marcoallegretti/Teresina-Rack/docs/review/analog-review/aux-and-analog-final-review.md

# Connected analog pages: final independent review

Pages 8 (CV inputs), 9 (auxiliary ADC/CV outputs) and 10 (gates) pass scoped native preservation and visual review. Other sheets remain drafts. No CAD files were edited by this reviewer.

All 211 components and 856 native pin nets, functions and types independently match the core candidate after removing only the root slash. All analog values, order codes, footprints, datasheets and electrical descriptions remain unchanged. The sole non-sheet documentary delta is U3 Description, duplicated in its description tag and field. The separate core review accepted its library alias and description normalization. All 84 raw analog symbol instances preserve units, library IDs, symbol/pin UUIDs and electrical property strings.

The final filtered CV input nodes are exactly:

- CVO_FILT_1: R152.2, C138.1 and U15.3.
- CVO_FILT_2: R153.2, C139.1 and U15.5.

Explicit T junctions now connect both capacitor branches to the opamp plus-input wires. The earlier disconnected RC export was rejected. Both 62 kΩ/120 kΩ feedback loops are visible and sense their outputs before the 100 Ω series resistors. The shared U15 supply is clearly referenced to the gates sheet.

Each auxiliary ADC channel visibly includes 1 kΩ series resistance and 1 nF to ground. Actual MCU symbol functions remain PA1_N2, PA0_N3, PC3_C_M5 and PC2_C_M4 for channels 9–12, respectively. This preserves the reviewed core connections; it is not a separate firmware qualification claim.

ADC 10 and 12 groups moved left by 6.35 mm. The final crop confirms both output label boxes clear the inner drawing frame. No material overlap between text, pins or component bodies, or hidden feedback path, was found on the three reviewed pages. Prior scoped visual acceptance for CV inputs and gates is retained.

The reviewed PDF is newer than all three sheets, and its saved hash still matches the current final export. `aux-and-analog-final-review.json` records PDF, sheet and XML hashes, exact RC/feedback memberships, ADC mappings and evidence PNG filenames. Fresh ERC retains three pin-to-pin errors and one library mismatch. Exact device behavior, rail/headroom limits, fault protection, noise/THD, effective capacitance, physical bypass placement and PCB parity remain open. Readability does not certify those checks; this is not whole-schematic or production acceptance.
