marcoallegretti/Teresina-Rack/docs/review/analog-review/connected-cv-gates-review.md

# Connected CV/gate sheet review

Pages8(CVinputs) and10(gates) pass scoped native and visual review. Fresh PDF is newer than both revised sheets; hashes and evidence are in `connected-cv-gates-review.json`. All211 components and856 native pins/nets/functions/types and every non-sheet field still exactly match the reviewed core candidate after removing only root net-name slash.

Eight CV stages now show each100k input,200k negative-reference bias, grounded noninverting input and33k/220pF parallel feedback as visible connected circuitry. Both gates show62k/120k closed negative feedback sensed before100Ω output isolation. Transistor input paths visibly preserve100k,1M,10k pullup and1k MCU series connections. No material text/pin/body overlap or hidden feedback path was found at the reviewed rendered scale. Labels and component references/values are readable.

This accepts only these two schematic pages, not physical placement, cap ownership, remaining grid pages, fault protection, measured analog behavior or PCB/production readiness. Other pages remain presentation drafts and retain the preceding review limits. No CAD edits were made by this review.
