marcoallegretti/Teresina-Rack/docs/review/power-fab-review/review.md

# Power and fabrication review — 13 October 2026

Inputs: native XML netlist under `redesign/baseline`, raw `TeresinaRack.kicad_pcb`, the retained kicad-happy PCB report, Electro-Smith Patch SM datasheet v1.0.5 and rev3 schematic. No design files were changed. Geometry was checked independently against raw board text; `power-geometry.json` confirms agreement with kicad-happy. PDFs identified as HTML challenge pages were excluded from the verified-PDF manifest.

## Confirmed electrical and assembly blockers

| Item | Confirmed evidence | Required correction |
|---|---|---|
| L1 | `NLCV32T-220K-EF` is **22 µH**, ±10%, nominal DCR **0.77 Ω ±30%**, rated current **300 mA**. The schematic says 2.2 µH. TDK catalog p1; LCSC C250233 agrees and does not provide Isat. | Select an actual power inductor with an explicit saturation/thermal rating. Do not relabel this part to 2.2 µH. TI recommends 2.2 or 3.3 µH with supported LC combinations; 22 µH is outside its proven table. |
| FB1, FB2 | `MCR03EZPFX3600` is a ROHM **360 Ω ±1%, 100 mW resistor**, not a 600 Ω@100 MHz ferrite. Manufacturer MCR03 EZP p1; LCSC C559338 confirms exact value. | Correct MPN and LCSC mapping after defining ferrite requirements, or remove obsolete branches only after circuit review. These two branches are not the main positive input path: FB2 leads to UNREG/R11/A_IN capacitors; FB1 connects +3V3 A to A_OUT/C50. Neither terminates in an active regulator. |
| FB3, FB5, FB7, FB8, FB9 | `CR0805FR600P05Z` is an EVER OHMS **0.600 Ω ±1%, 125 mW resistor**, not a ferrite. Manufacturer CR-series p1/p4; LCSC C175716 gives exact resistance and type. | Select actual ferrites with DC current, DCR, impedance/bias and package verification. For this resistor, 500 mA gives 150 mW, above 125 mW rating; 800 mA gives 384 mW. It cannot carry the claimed rail maxima. |
| D1, D2, D5 | Exact `NSR1020MW2T1G` uses **SOD-323**; the board uses **SOD-923**. Manufacturer NSR1020MW2/D rev3 p1 and package drawing p3; LCSC C116953 independently confirms. | Replace all three footprints with verified SOD-323 land patterns or select an exact suitably rated SOD-923 alternative. Preserve cathode pin1/anode pin2. Existing diode *net polarity* agrees with intended positive/negative/USB ORing. |
| C50 | `CL10A226MQ8NRNC` is **22 µF, X5R, ±20%, 6.3 V**, not the displayed 2.2 µF. Samsung MLCC catalog PDF p4 numbering; exact LCSC C59461 agrees. | Resolve value/MPN mismatch and the dead A_OUT branch together. This capacitor is not the buck output capacitor. |
| C57, C59, C112, C113, C63 | `CL05B104KO5NNNC` is **100 nF, 16 V, X7R ±10%**. They are on protected ±12 V or LD_IN. Official positive/negative input envelope reaches ±17 V. Diode drops do not bring that safely below 16 V. Samsung catalog p4; C1525 product properties. | Select at least 25 V rated devices, then verify capacitance under actual bias and transient envelope. Check other 16 V parts on these rails systematically. |
| U7 at high input | ST LD1117 p7 gives 15 V DC-input absolute rating, with 18 V allowed **only below 20 mA output**. P13 operating maximum is 15 V; 5 V regulation specification covers Vin6.5..15 V. Carrier17 V minus diode remains above15 V. | Resolve the input-envelope requirement before approving U7. A higher-rated regulator or a documented limited compatibility envelope is necessary; restricting input silently would violate the requested compatibility. |
| U6 local layout | Center distances from U6: C45 input bulk10.77 mm, C46 output bulk16.04 mm, L1 4.66 mm, R12 14.68 mm on opposite side, R13 **52.28 mm**. FB_BK has67.964 mm routed copper/4vias over5layers; SW_BK9.827 mm copper. Raw and analyzer coordinates agree. TI p25 requires input/output caps, inductor and divider close to their respective pins. | Rebuild power cells as coherent placements: input cap directly VIN/PGND, SW–inductor–output-cap compact, VOS directly at output cap, FB divider near FB/AGND away from SW. No inherited feedback routing should be reused. Distances are observations, not invented universal DRC limits. |
| U7 output decoupling | No capacitor exists on LD_OUT itself; C60 lies after FB8 and23.98 mm from U7; C63 is opposite side7.04 mm away. ST p1 requires minimum10 µF for stability; p8 supplies application arrangement. | Provide local regulator output capacitor directly at VOUT/GND with technology/stability and effective-capacitance verification; place ferrite/filter downstream. Do not infer guaranteed stability from an aggregate10 µF elsewhere on the rail. |

TPS62170 physical pin table p3 matches the native design: 1PGND,2VIN,3EN,4AGND,5FB,6VOS,7SW,8PG, exposed padAGND. PG can float per p3. Divider47k/15k gives `0.8*(1+47/15)=3.3067 V`; lowering both official470k/150k values tenfold preserves ratio and meets TI's lower-resistance recommendation. LD1117 SOT223 pins1GND/2VOUT/3VIN and tabVOUT also agree. These confirmations do not validate the inappropriate BOM or remote layout.

## Power modes and budget boundaries

- Positive carrier input passes D1 to the internal positive rail; USB VBUS passes D5 to that rail. D1/D5 inhibit intentional reverse feed into carrier/USB. Reverse leakage remains: manufacturer p2 specifies40 µA maximum at15 V/25 °C; visual review corrects the text extractor's incorrect `mA` unit. Higher-temperature curves have greater leakage. This topology is not galvanic isolation or a zero-backfeed guarantee.
- Negative supply D2 orientation is correct for negative-rail reverse-polarity protection. A series diode cannot be credited as overvoltage clamping or surge protection.
- USB-only supplies the buck/MCU but cannot produce a regulated5 V with a 5 V LDO fed below5 V, nor the negative audio rail/reference. Official datasheet printedp2 explicitly allows partial USB power for firmware updates and says the codec will not function properly. Validate actual reset/DFU/memory behavior and current negotiation on hardware. Do not describe USB-only as full audio operation.
- With positive carrier power present, D5 reverse stress is roughly positive-rail minus VBUS; 17 V carrier with no USB is within the diode20 V continuous reverse rating, with limited transient margin. With reversed−17 V at positive carrier input while USB holds internal rail near+4.7 V, D1 sees about21.7 V, beyond20 V continuous reverse rating (30 V peak rating does not authorize sustained operation). Decide and validate the complete misconnection/transient contract.
- TPS62170 is rated500 mA **total** output. Internal MCU, SDRAM, QSPI, codec digital current and external A10 load share it. Official datasheet printedp2 describes500 mA as an absolute maximum output and marks it firmware dependent; do not turn that into guaranteed external500 mA on top of internal load. Compute peak/startup and workload-specific residual budget.
- LD1117 output800 mA is also shared by the codec analog supply, twelve MCP6004 amplifiers and external A6. At a representative protected11.7 V, dissipation is `6.7*Iout + 11.7*Iq`, where ST gives Iq5 mA typical/10 mA max. At100 mA, this is0.729..0.787 W. At800 mA,5.419..5.477 W. ST SOT223 reference θJA110 °C/W, θJC15 °C/W, max junction125 °C (p7) do not validate any particular PCB's heat spreading. At40 °C ambient the reference model permits only~0.773 W total before125 °C, illustrating why external800 mA cannot be promised continuously at12 V without a very different thermal solution. No unconditional current limit is approved from this reference calculation; characterize the actual copper/airflow/load and operate below the junction maximum with design margin.
- Near6 V carrier, even a correct LD1117 is close to dropout after D1 and filter drops. ST's guaranteed5 V table begins6.5 V at the IC. Equivalent minimum-input performance requires a supported power solution, not an assumption that absolute input limits guarantee precise5 V.

The official rev3 power sheet uses `SRP2010-2R2M` for its buck. Bourns manufacturer PDF p1 confirms2.2 µH±20%, DCR150mΩ, Irms1.7 A, Isat1.9 A with datasheet test definitions. It is a valid *candidate* reference part, not a footprint-compatible replacement for present1210 L1. TI p14 prescribes saturation above computed `Iout+ΔIL/2` plus approximately20% margin, and recommends3.3 µH at low inputs for full output current. Calculate using minimum effective inductance and actual frequency, then verify selected orderable part and placement. TI p13/p15 expects a supported LC pair, accounting for ±20% assumed bias/tolerance variation; distributing capacitors across the board does not substitute for a local output filter.

## JLCPCB process requirements and four-layer feasibility

Official sources accessed13 October 2026: [capabilities](https://jlcpcb.com/capabilities/pcb-capabilities), [stackups](https://jlcpcb.com/impedance), [via covering](https://jlcpcb.com/help/article/pcb-via-covering). Captured text/state and raw via/stackup HTML are retained here; the shared capabilities HTML is under `redesign/sources`. The capability tables differ from stale generic tool presets and must be translated without arbitrary relaxation.

| Feature | Official published capability | Recommended starting condition |
|---|---|---|
| Multilayer trace/space,1 oz |0.09/0.09 mm;3mil acceptable in BGA fanouts |0.10/0.10 mm generally; locally0.09 where escape demands it. Do not invoke3mil automatically. Wider power geometry based on actual currents. |
| Multilayer via |0.15 mm drill/0.25 mm land; land diameter at least0.10 mm above drill,0.15 mm preferred |0.15 mm drill with0.30 mm land for MCU escape, subject to actual pad pattern/process acceptance; larger when space permits.0.15 mm drilling has surcharge. |
|0.10 mm drill/0.20 mm land |Only thickness≤1 mm and ENIG/OSP |Do not use to rescue a1.6 mm mechanical target. |
| Copper drill spacing |Via hole-to-hole0.20 mm; via-hole-to-track0.20 mm; inner via-hole-to-copper0.20 mm |Encode separately from ordinary copper clearance. A copper0.09 mm rule alone is insufficient. Scope same-net land exceptions explicitly. |
| PTH annular ring |Multilayer1 oz recommended0.20 mm,absolute minimum0.15 mm |Use0.20 mm for headers when mechanically possible. Do not conflate PTH pad ring with published fine-via diameter-minus-drill rule. |
| BGA |Minimum pad0.20 mm;0.20..0.25 mm pads require ENIG; pad-track0.10 mm minimum,0.09 locally multilayer |Verify MCU0.65 mm and SDRAM0.80 mm pitch footprint balls/lands against manufacturer, and choose ENIG for reviewable flat fine-pitch assembly. |
| Via-in-pad |Filled and plated-over vias supported; epoxy/copper-paste filled+capped, compatible via diameters0.15..0.55 mm |Specify **epoxy filled and copper capped** for every open barrel in paste/pads. Soldermask plugging/tenting is not a substitute. Four-layer ordering must explicitly select paid process; free/default6+ availability does not make4layers impossible. Supplier order review must accept the selected hole set. |
| Soldermask |SinceJune2025 pad/mask can be1:1; ≥0.09 mm mask-opening to neighboring trace; green/red/yellow/blue/purple bridge0.10 mm,black/white0.13 mm |Use green and reviewed mask apertures/bridges. No arbitrary mask-dam waivers. |

A0.65 mm-pitch array with0.15 mm drilled vias leaves0.50 mm between adjacent drill edges. One0.09 mm track plus two0.20 mm hole clearances consumes0.49 mm: only0.01 mm nominal spare before geometry/tolerance, and two tracks cannot fit. This simple corridor calculation proves neither success nor failure for the full fanout. Assess actual diagonal corridors, pads, anti-pads, voids and ground continuity with native DRC and drilling constraints.0.80 mm SDRAM has more local room but the actual crossovers, power delivery and timings still govern feasibility. Through-vias must cross every layer with appropriate keepouts and plane anti-pads.

The actual official1.6 mm/1 oz outer/0.5 oz inner stackup response includes19four-layer and17six-layer templates. Examples:

- **JLC04161H-3313:** outer copper0.035 mm; outer-to-plane prepreg0.09940 mm each side; L2/L3 copper0.0152 mm each; core1.265 mm. Good candidate for four layers with outer signal/power and two continuous inner ground references. Distribute power on outer copper with explicit budget; plane perforation/return-path review remains mandatory. A split power plane under unrelated fast signals is not automatically an acceptable reference.
- **JLC04161H-1080:** outer-to-plane0.07640 mm each side; core1.265 mm, same copper, another named four-layer option to evaluate for impedance/fanout.
- **JLC04161H-7628:** outer-to-plane0.21040 mm/core1.065 mm; materially different signal impedance/coupling, so generic1.6 mm assumptions are inadequate.
- **JLC06161H-3313:** outer-to-L2/L5 prepreg0.09940 mm, two0.55 mm cores, central2116prepreg0.1088 mm, same1 oz/0.5 oz copper. This supplies more copper layers but layer assignments still require continuous nearby references; it does not automatically fix return paths.

These are manufacturer-enabled response entries, not a saved quotation/order approval. The legacy official impedance page exposes4and6templates only; no exact8layer template was established during this review. Eight remains final fallback, to be sourced and independently reviewed **only after documented4and6failure**. Increasing layers will not correct wrong parts, bad power loops, pin-map errors or thermal limits.

## Sourcing evidence and remaining gates

`live-sourcing.csv` records exact LCSC product pages, PDF URLs, prices and retail stock at retrieval. C12891±12V22µF25 V caps have0 stock; TPS C124041: 293; L1C250233: 30,100; NSR C116953: 2,655; U7C81157: 6,670; C559338: 700 and C175716: 1,600 are available **wrong resistor** mappings. Stock is not evidence of suitability. JLC assembly allocation/basic-vs-extended status remains unverified; retail availability does not reserve PCBA stock. Manufacturer-branded PDFs are retained and SHA256-recorded. Direct onsemi URL returnedHTML, so the valid NSR mirror from LCSC was used. Manufacturer/data distributor/geometry evidence agree on the principal defects above.

Before any routing acceptance: freeze complete corrected BOM, input/USB/rail budgets and mechanical thickness; prepare explicit4layer stackup and via/paste process; place power and high-speed cells; then perform native DRC/refill/ERC, KiCadRoutingTools connectivity and cleanliness, independent timing/reference/ampacity checks, Gerber/drill/BOM/CPL verification. Before production claims, hardware load/startup/USB/hotplug/DFU/temperature and complete firmware functional tests are required. Current sources confirm blockers, not readiness.

## Datasheet references

- [TI TPS62170](https://www.ti.com/lit/ds/symlink/tps62170.pdf), SLVSAT8E, pp 3,5,13–15,25–26.
- [ST LD1117](https://www.st.com/resource/en/datasheet/ld1117.pdf), DocID2572rev38, pp 1,6–8,13.
- [TDK NLCV32-EF](https://product.tdk.com/system/files/dam/doc/product/inductor/inductor/smd/catalog/inductor_commercial_decoupling_nlcv32-ef_en.pdf), dated20180920,p1 (six-page family sheet).
- [ROHM MCR03EZP](https://fscdn.rohm.com/en/products/databook/datasheet/passive/resistor/chip_resistor/mcr03-e.pdf),pp 1,4; [exact C559338](https://www.lcsc.com/product-detail/C559338.html).
- [EVER OHMS CRseries mirror](https://datasheet.lcsc.com/datasheet/pdf/f47198ef4592e2cee10f8fce26a2aade.pdf?productCode=C175716),20190312,pp 1,4; [exact C175716](https://www.lcsc.com/product-detail/C175716.html).
- [onsemi NSR1020MW2 mirror](https://datasheet.lcsc.com/datasheet/pdf/e138ba6d5451d1c88ae9df7d3ef01a95.pdf?productCode=C116953),March2016rev3,pp 1–3.
- [Samsung MLCC catalog mirror](https://datasheet.lcsc.com/datasheet/pdf/02336ea48ea44ca18c72517dd3cb7b47.pdf?productCode=C59461),PDFp4 part numbering; [C1525](https://www.lcsc.com/product-detail/C1525.html),[C59461](https://www.lcsc.com/product-detail/C59461.html),[C12891](https://www.lcsc.com/product-detail/C12891.html) exact orderable properties.
- [Bourns SRP2010](https://www.bourns.com/docs/product-datasheets/srp2010.pdf),p1.
- Electro-Smith sources retained in shared `redesign/sources`: datasheetv1.0.5 printedp2 and official schematic rev3 sheet3/4.
