marcoallegretti/Teresina-Rack/docs/review/component-review.csv

reference | value | mpn | lcsc | footprint | side | x_mm | y_mm | datasheet | review_status | circuit_review_group | connected_nets | placement_requirement
C1 | 100nF | CL05B104KO5NNNC | C1525 | Capacitor_SMD:C_0402_1005Metric | B.Cu | 5.488 | 17.016 |  | pinout/dimensions/sourcing review required | Power distribution; pin-level owner pending | +3V3;GND | Place by datasheet pin/loop requirements after source review; existing coordinates are not approved
C10 | 100nF | CL05B104KO5NNNC | C1525 | Capacitor_SMD:C_0402_1005Metric | B.Cu | 30.775 | 20.931 |  | pinout/dimensions/sourcing review required | Power distribution; pin-level owner pending | +3V3;GND | Place by datasheet pin/loop requirements after source review; existing coordinates are not approved
C100 | 2.2uF | CL21A226MAQNNNE | C45783 | Capacitor_SMD:C_0805_2012Metric | F.Cu | 24 | 31.03 |  | pinout/dimensions/sourcing review required | Audio/codec; pin-level owner pending | INPUT_AUDIO_RIGHT;N_RINA | Place by datasheet pin/loop requirements after source review; existing coordinates are not approved
C101 | 220pF | 0402B221K500NT | C1530 | Capacitor_SMD:C_0402_1005Metric | B.Cu | 26.86 | 8.917 |  | pinout/dimensions/sourcing review required | Power distribution; pin-level owner pending | RINR_M;RINR_O | Place by datasheet pin/loop requirements after source review; existing coordinates are not approved
C102 | 100nF | CL05B104KO5NNNC | C1525 | Capacitor_SMD:C_0402_1005Metric | B.Cu | 32.759 | 13.867 |  | pinout/dimensions/sourcing review required | Audio/codec; pin-level owner pending | CODEC_VCOM;GND | Place by datasheet pin/loop requirements after source review; existing coordinates are not approved
C103 | 2.2uF | CL21A226MAQNNNE | C45783 | Capacitor_SMD:C_0805_2012Metric | F.Cu | 24.074 | 34.265 |  | pinout/dimensions/sourcing review required | Audio/codec; pin-level owner pending | INPUT_AUDIO_LEFT;N_LINA | Place by datasheet pin/loop requirements after source review; existing coordinates are not approved
C104 | 220pF | 0402B221K500NT | C1530 | Capacitor_SMD:C_0402_1005Metric | B.Cu | 39.525 | 36.086 |  | pinout/dimensions/sourcing review required | Power distribution; pin-level owner pending | LINL_M;LINL_O | Place by datasheet pin/loop requirements after source review; existing coordinates are not approved
C105 | 100nF | CL05B104KO5NNNC | C1525 | Capacitor_SMD:C_0402_1005Metric | B.Cu | 31.8 | 4 |  | pinout/dimensions/sourcing review required | Audio/codec; pin-level owner pending | CODEC_VCOM;GND | Place by datasheet pin/loop requirements after source review; existing coordinates are not approved
C11 | 4.7uF | CL21A475KAQNNNE | C1779 | Capacitor_SMD:C_0805_2012Metric | F.Cu | 21.574 | 9.15 |  | pinout/dimensions/sourcing review required | Power distribution; pin-level owner pending | +3V3;GND | Place by datasheet pin/loop requirements after source review; existing coordinates are not approved
C112 | 100nF | CL05B104KO5NNNC | C1525 | Capacitor_SMD:C_0402_1005Metric | B.Cu | 32.525 | 23.962 |  | pinout/dimensions/sourcing review required | Power distribution; pin-level owner pending | +12V;GND | Place by datasheet pin/loop requirements after source review; existing coordinates are not approved
C113 | 100nF | CL05B104KO5NNNC | C1525 | Capacitor_SMD:C_0402_1005Metric | B.Cu | 15.903 | 32.904 |  | pinout/dimensions/sourcing review required | Power distribution; pin-level owner pending | -12V;GND | Place by datasheet pin/loop requirements after source review; existing coordinates are not approved
C12 | 4.7uF | CL21A475KAQNNNE | C1779 | Capacitor_SMD:C_0805_2012Metric | F.Cu | 28.827 | 7.219 |  | pinout/dimensions/sourcing review required | Power distribution; pin-level owner pending | +3V3;GND | Place by datasheet pin/loop requirements after source review; existing coordinates are not approved
C120 | 18pF | 0402CG180J500NT | C1549 | Capacitor_SMD:C_0402_1005Metric | B.Cu | 28 | 2 |  | pinout/dimensions/sourcing review required | Power distribution; pin-level owner pending | OL_INV;OL_OUT | Place by datasheet pin/loop requirements after source review; existing coordinates are not approved
C121 | 100pF | 0402CG101J500NT | C1546 | Capacitor_SMD:C_0402_1005Metric | B.Cu | 25.306 | 28.423 |  | pinout/dimensions/sourcing review required | Audio/codec; pin-level owner pending | N_OLA;N_OLB | Place by datasheet pin/loop requirements after source review; existing coordinates are not approved
C122 | 18pF | 0402CG180J500NT | C1549 | Capacitor_SMD:C_0402_1005Metric | B.Cu | 3.611 | 18.591 |  | pinout/dimensions/sourcing review required | Power distribution; pin-level owner pending | GND;OL_NINV | Place by datasheet pin/loop requirements after source review; existing coordinates are not approved
C123 | 18pF | 0402CG180J500NT | C1549 | Capacitor_SMD:C_0402_1005Metric | B.Cu | 12.625 | 18.506 |  | pinout/dimensions/sourcing review required | Power distribution; pin-level owner pending | OR_INV;OR_OUT | Place by datasheet pin/loop requirements after source review; existing coordinates are not approved
C124 | 100pF | 0402CG101J500NT | C1546 | Capacitor_SMD:C_0402_1005Metric | B.Cu | 35.753 | 9.37 |  | pinout/dimensions/sourcing review required | Audio/codec; pin-level owner pending | N_ORA;N_ORB | Place by datasheet pin/loop requirements after source review; existing coordinates are not approved
C125 | 18pF | 0402CG180J500NT | C1549 | Capacitor_SMD:C_0402_1005Metric | B.Cu | 34.636 | 15.442 |  | pinout/dimensions/sourcing review required | Power distribution; pin-level owner pending | GND;OR_NINV | Place by datasheet pin/loop requirements after source review; existing coordinates are not approved
C126 | 220pF | 0402B221K500NT | C1530 | Capacitor_SMD:C_0402_1005Metric | B.Cu | 27.86 | 6.497 |  | pinout/dimensions/sourcing review required | CV/gate analog; channel owner pending | CV_1;SUM_1 | Place by datasheet pin/loop requirements after source review; existing coordinates are not approved
C127 | 220pF | 0402B221K500NT | C1530 | Capacitor_SMD:C_0402_1005Metric | B.Cu | 33.4 | 25.477 |  | pinout/dimensions/sourcing review required | CV/gate analog; channel owner pending | CV_2;SUM_2 | Place by datasheet pin/loop requirements after source review; existing coordinates are not approved
C128 | 220pF | 0402B221K500NT | C1530 | Capacitor_SMD:C_0402_1005Metric | B.Cu | 15.408 | 8.692 |  | pinout/dimensions/sourcing review required | CV/gate analog; channel owner pending | CV_3;SUM_3 | Place by datasheet pin/loop requirements after source review; existing coordinates are not approved
C129 | 220pF | 0402B221K500NT | C1530 | Capacitor_SMD:C_0402_1005Metric | B.Cu | 35.15 | 28.509 |  | pinout/dimensions/sourcing review required | CV/gate analog; channel owner pending | CV_4;SUM_4 | Place by datasheet pin/loop requirements after source review; existing coordinates are not approved
C13 | 2.2uF | CL10A226MQ8NRNC | C59461 | Capacitor_SMD:C_0603_1608Metric | F.Cu | 21 | 7 |  | pinout/dimensions/sourcing review required | Power distribution; pin-level owner pending | GND;VCAP | Place by datasheet pin/loop requirements after source review; existing coordinates are not approved
C130 | 220pF | 0402B221K500NT | C1530 | Capacitor_SMD:C_0402_1005Metric | B.Cu | 7.364 | 15.442 |  | pinout/dimensions/sourcing review required | CV/gate analog; channel owner pending | CV_5;SUM_5 | Place by datasheet pin/loop requirements after source review; existing coordinates are not approved
C131 | 220pF | 0402B221K500NT | C1530 | Capacitor_SMD:C_0402_1005Metric | B.Cu | 26.826 | 37.04 |  | pinout/dimensions/sourcing review required | CV/gate analog; channel owner pending | CV_6;SUM_6 | Place by datasheet pin/loop requirements after source review; existing coordinates are not approved
C132 | 220pF | 0402B221K500NT | C1530 | Capacitor_SMD:C_0402_1005Metric | B.Cu | 25.914 | 31.87 |  | pinout/dimensions/sourcing review required | CV/gate analog; channel owner pending | CV_7;SUM_7 | Place by datasheet pin/loop requirements after source review; existing coordinates are not approved
C133 | 220pF | 0402B221K500NT | C1530 | Capacitor_SMD:C_0402_1005Metric | B.Cu | 29.35 | 4 |  | pinout/dimensions/sourcing review required | CV/gate analog; channel owner pending | CV_8;SUM_8 | Place by datasheet pin/loop requirements after source review; existing coordinates are not approved
C134 | 1nF | 0402B102K500NT | C1523 | Capacitor_SMD:C_0402_1005Metric | B.Cu | 37.775 | 33.055 |  | pinout/dimensions/sourcing review required | Auxiliary ADC | ADC_9;GND | Place by datasheet pin/loop requirements after source review; existing coordinates are not approved
C135 | 1nF | 0402B102K500NT | C1523 | Capacitor_SMD:C_0402_1005Metric | B.Cu | 26.522 | 35.317 |  | pinout/dimensions/sourcing review required | Auxiliary ADC | ADC_10;GND | Place by datasheet pin/loop requirements after source review; existing coordinates are not approved
C136 | 1nF | 0402B102K500NT | C1523 | Capacitor_SMD:C_0402_1005Metric | B.Cu | 13.5 | 16.99 |  | pinout/dimensions/sourcing review required | Auxiliary ADC | ADC_11;GND | Place by datasheet pin/loop requirements after source review; existing coordinates are not approved
C137 | 1nF | 0402B102K500NT | C1523 | Capacitor_SMD:C_0402_1005Metric | B.Cu | 35.5 | 2 |  | pinout/dimensions/sourcing review required | Auxiliary ADC | ADC_12;GND | Place by datasheet pin/loop requirements after source review; existing coordinates are not approved
C138 | 1nF | 0402B102K500NT | C1523 | Capacitor_SMD:C_0402_1005Metric | B.Cu | 2.3 | 10.806 |  | pinout/dimensions/sourcing review required | CV/gate analog; channel owner pending | CVO_FILT_1;GND | Place by datasheet pin/loop requirements after source review; existing coordinates are not approved
C139 | 1nF | 0402B102K500NT | C1523 | Capacitor_SMD:C_0402_1005Metric | B.Cu | 51.75 | 4 |  | pinout/dimensions/sourcing review required | CV/gate analog; channel owner pending | CVO_FILT_2;GND | Place by datasheet pin/loop requirements after source review; existing coordinates are not approved
C14 | 2.2uF | CL10A226MQ8NRNC | C59461 | Capacitor_SMD:C_0603_1608Metric | F.Cu | 56.227 | 14.112 |  | pinout/dimensions/sourcing review required | Power distribution; pin-level owner pending | GND;VCAP | Place by datasheet pin/loop requirements after source review; existing coordinates are not approved
C140 | 100nF | CL05B104KO5NNNC | C1525 | Capacitor_SMD:C_0402_1005Metric | B.Cu | 33 | 2 |  | pinout/dimensions/sourcing review required | 10V reference | GND;VREF_N10 | Place by datasheet pin/loop requirements after source review; existing coordinates are not approved
C141 | 100nF | CL05B104KO5NNNC | C1525 | Capacitor_SMD:C_0402_1005Metric | B.Cu | 15.6 | 34.628 |  | pinout/dimensions/sourcing review required | Power distribution; pin-level owner pending | +5V;GND | Place by datasheet pin/loop requirements after source review; existing coordinates are not approved
C142 | 100nF | CL05B104KO5NNNC | C1525 | Capacitor_SMD:C_0402_1005Metric | B.Cu | 16.694 | 28.423 |  | pinout/dimensions/sourcing review required | Power distribution; pin-level owner pending | +5V;GND | Place by datasheet pin/loop requirements after source review; existing coordinates are not approved
C143 | 100nF | CL05B104KO5NNNC | C1525 | Capacitor_SMD:C_0402_1005Metric | B.Cu | 36.025 | 30.024 |  | pinout/dimensions/sourcing review required | Power distribution; pin-level owner pending | +5V;GND | Place by datasheet pin/loop requirements after source review; existing coordinates are not approved
C15 | 1uF | CL05A105KA5NQNC | C52923 | Capacitor_SMD:C_0402_1005Metric | B.Cu | 15.25 | 13.959 |  | pinout/dimensions/sourcing review required | Power distribution; pin-level owner pending | +3V3A;GND | Place by datasheet pin/loop requirements after source review; existing coordinates are not approved
C16 | 100nF | CL05B104KO5NNNC | C1525 | Capacitor_SMD:C_0402_1005Metric | B.Cu | 58.447 | 17.63 |  | pinout/dimensions/sourcing review required | Power distribution; pin-level owner pending | +3V3A;GND | Place by datasheet pin/loop requirements after source review; existing coordinates are not approved
C17 | 1uF | CL05A105KA5NQNC | C52923 | Capacitor_SMD:C_0402_1005Metric | B.Cu | 15.127 | 1.862 |  | pinout/dimensions/sourcing review required | Power distribution; pin-level owner pending | +3V3A;GND | Place by datasheet pin/loop requirements after source review; existing coordinates are not approved
C18 | 100nF | CL05B104KO5NNNC | C1525 | Capacitor_SMD:C_0402_1005Metric | B.Cu | 11.75 | 20.021 |  | pinout/dimensions/sourcing review required | Power distribution; pin-level owner pending | +3V3;GND | Place by datasheet pin/loop requirements after source review; existing coordinates are not approved
C19 | 100nF | CL05B104KO5NNNC | C1525 | Capacitor_SMD:C_0402_1005Metric | B.Cu | 14.992 | 38.074 |  | pinout/dimensions/sourcing review required | Power distribution; pin-level owner pending | +3V3;GND | Place by datasheet pin/loop requirements after source review; existing coordinates are not approved
C2 | 100nF | CL05B104KO5NNNC | C1525 | Capacitor_SMD:C_0402_1005Metric | B.Cu | 15.296 | 36.351 |  | pinout/dimensions/sourcing review required | Power distribution; pin-level owner pending | +3V3;GND | Place by datasheet pin/loop requirements after source review; existing coordinates are not approved
C20 | 100nF | CL05B104KO5NNNC | C1525 | Capacitor_SMD:C_0402_1005Metric | B.Cu | 40.4 | 37.602 |  | pinout/dimensions/sourcing review required | Power distribution; pin-level owner pending | +3V3;GND | Place by datasheet pin/loop requirements after source review; existing coordinates are not approved
C201 | 2.2uF | CL10A225KO8NNNC | C23630 | C_0603_1608Metric | B.Cu | 54 | 30.8 |  | pinout/dimensions/sourcing review required | Reset/boot | BOOT0;GND | Place by datasheet pin/loop requirements after source review; existing coordinates are not approved
C202 | 100nF | CL05B104KO5NNNC | C1525 | Capacitor_SMD:C_0402_1005Metric | B.Cu | 38.5 | 6.4 |  | pinout/dimensions/sourcing review required | Power distribution; pin-level owner pending | +5VA;GND | Place by datasheet pin/loop requirements after source review; existing coordinates are not approved
C203 | 10uF | CL21A106KAYNNNE | C15850 | Capacitor_SMD:C_0805_2012Metric | B.Cu | 43.2 | 31.8 |  | pinout/dimensions/sourcing review required | Power distribution; pin-level owner pending | +5VA;GND | Place by datasheet pin/loop requirements after source review; existing coordinates are not approved
C204 | 100nF | CL05B104KO5NNNC | C1525 | Capacitor_SMD:C_0402_1005Metric | F.Cu | 44 | 15.2 |  | pinout/dimensions/sourcing review required | Power distribution; pin-level owner pending | +3V3;GND | Place by datasheet pin/loop requirements after source review; existing coordinates are not approved
C205 | 100nF | CL05B104KO5NNNC | C1525 | Capacitor_SMD:C_0402_1005Metric | F.Cu | 42.95 | 23 |  | pinout/dimensions/sourcing review required | Power distribution; pin-level owner pending | +3V3;GND | Place by datasheet pin/loop requirements after source review; existing coordinates are not approved
C206 | 100nF | CL05B104KO5NNNC | C1525 | Capacitor_SMD:C_0402_1005Metric | F.Cu | 44 | 24.95 |  | pinout/dimensions/sourcing review required | Power distribution; pin-level owner pending | +3V3;GND | Place by datasheet pin/loop requirements after source review; existing coordinates are not approved
C207 | 100nF | CL05B104KO5NNNC | C1525 | Capacitor_SMD:C_0402_1005Metric | F.Cu | 49.2 | 22.8 |  | pinout/dimensions/sourcing review required | Power distribution; pin-level owner pending | +3V3;GND | Place by datasheet pin/loop requirements after source review; existing coordinates are not approved
C21 | 100nF | CL05B104KO5NNNC | C1525 | Capacitor_SMD:C_0402_1005Metric | B.Cu | 24.3 | 9.716 |  | pinout/dimensions/sourcing review required | Power distribution; pin-level owner pending | +3V3;GND | Place by datasheet pin/loop requirements after source review; existing coordinates are not approved
C22 | 100nF | CL05B104KO5NNNC | C1525 | Capacitor_SMD:C_0402_1005Metric | B.Cu | 30.491 | 7.454 |  | pinout/dimensions/sourcing review required | Power distribution; pin-level owner pending | +3V3;GND | Place by datasheet pin/loop requirements after source review; existing coordinates are not approved
C23 | 100nF | CL05B104KO5NNNC | C1525 | Capacitor_SMD:C_0402_1005Metric | B.Cu | 36.512 | 17.016 |  | pinout/dimensions/sourcing review required | Power distribution; pin-level owner pending | +3V3;GND | Place by datasheet pin/loop requirements after source review; existing coordinates are not approved
C24 | 100nF | CL05B104KO5NNNC | C1525 | Capacitor_SMD:C_0402_1005Metric | B.Cu | 55.816 | 16.672 |  | pinout/dimensions/sourcing review required | Power distribution; pin-level owner pending | +3V3;GND | Place by datasheet pin/loop requirements after source review; existing coordinates are not approved
C25 | 100nF | CL05B104KO5NNNC | C1525 | Capacitor_SMD:C_0402_1005Metric | B.Cu | 61.078 | 18.587 |  | pinout/dimensions/sourcing review required | Power distribution; pin-level owner pending | +3V3;GND | Place by datasheet pin/loop requirements after source review; existing coordinates are not approved
C26 | 100nF | CL05B104KO5NNNC | C1525 | Capacitor_SMD:C_0402_1005Metric | F.Cu | 30.5 | 14 |  | pinout/dimensions/sourcing review required | Power distribution; pin-level owner pending | +3V3;GND | Place by datasheet pin/loop requirements after source review; existing coordinates are not approved
C27 | 4.7uF | CL21A475KAQNNNE | C1779 | Capacitor_SMD:C_0805_2012Metric | F.Cu | 24 | 37.5 |  | pinout/dimensions/sourcing review required | Power distribution; pin-level owner pending | +3V3;GND | Place by datasheet pin/loop requirements after source review; existing coordinates are not approved
C28 | 4.7uF | CL21A475KAQNNNE | C1779 | Capacitor_SMD:C_0805_2012Metric | F.Cu | 54.074 | 3.088 |  | pinout/dimensions/sourcing review required | Power distribution; pin-level owner pending | +3V3;GND | Place by datasheet pin/loop requirements after source review; existing coordinates are not approved
C29 | 100nF | CL05B104KO5NNNC | C1525 | Capacitor_SMD:C_0402_1005Metric | B.Cu | 34.275 | 26.993 |  | pinout/dimensions/sourcing review required | Power distribution; pin-level owner pending | +3V3;GND | Place by datasheet pin/loop requirements after source review; existing coordinates are not approved
C3 | 100nF | CL05B104KO5NNNC | C1525 | Capacitor_SMD:C_0402_1005Metric | B.Cu | 63.709 | 19.545 |  | pinout/dimensions/sourcing review required | Power distribution; pin-level owner pending | +3V3;GND | Place by datasheet pin/loop requirements after source review; existing coordinates are not approved
C30 | 100nF | CL05B104KO5NNNC | C1525 | Capacitor_SMD:C_0402_1005Metric | B.Cu | 31.65 | 22.446 |  | pinout/dimensions/sourcing review required | Power distribution; pin-level owner pending | +3V3;GND | Place by datasheet pin/loop requirements after source review; existing coordinates are not approved
C31 | 100nF | CL05B104KO5NNNC | C1525 | Capacitor_SMD:C_0402_1005Metric | B.Cu | 36.9 | 31.54 |  | pinout/dimensions/sourcing review required | Power distribution; pin-level owner pending | +3V3A;GND | Place by datasheet pin/loop requirements after source review; existing coordinates are not approved
C32 | 100nF | CL05B104KO5NNNC | C1525 | Capacitor_SMD:C_0402_1005Metric | B.Cu | 38.65 | 34.571 |  | pinout/dimensions/sourcing review required | Power distribution; pin-level owner pending | +3V3;GND | Place by datasheet pin/loop requirements after source review; existing coordinates are not approved
C34 | 10uF | CL21A106KAYNNNE | C15850 | Capacitor_SMD:C_0805_2012Metric | F.Cu | 51.074 | 8.284 |  | pinout/dimensions/sourcing review required | Power distribution; pin-level owner pending | +3V3A;GND | Place by datasheet pin/loop requirements after source review; existing coordinates are not approved
C35 | 10uF | CL21A106KAYNNNE | C15850 | Capacitor_SMD:C_0805_2012Metric | F.Cu | 36.074 | 30.765 |  | pinout/dimensions/sourcing review required | Power distribution; pin-level owner pending | GND;UNREG | Place by datasheet pin/loop requirements after source review; existing coordinates are not approved
C36 | 22uF | CL21A226MOQNNNE | C98190 | Capacitor_SMD:C_0805_2012Metric | F.Cu | 28.18 | 4.804 |  | pinout/dimensions/sourcing review required | Power distribution; pin-level owner pending | +3V3;GND | Place by datasheet pin/loop requirements after source review; existing coordinates are not approved
C37 | 18pF | 0402CG180J500NT | C1549 | Capacitor_SMD:C_0402_1005Metric | B.Cu | 54.2 | 4 |  | pinout/dimensions/sourcing review required | HSE clock | GND;OSC_IN | Place by datasheet pin/loop requirements after source review; existing coordinates are not approved
C38 | 18pF | 0402CG180J500NT | C1549 | Capacitor_SMD:C_0402_1005Metric | B.Cu | 51.5 | 2 |  | pinout/dimensions/sourcing review required | HSE clock | GND;OSC_OUT | Place by datasheet pin/loop requirements after source review; existing coordinates are not approved
C39 | 100nF | CL05B104KO5NNNC | C1525 | Capacitor_SMD:C_0402_1005Metric | B.Cu | 34.25 | 4 |  | pinout/dimensions/sourcing review required | Reset/boot | GND;NRST | Place by datasheet pin/loop requirements after source review; existing coordinates are not approved
C4 | 100nF | CL05B104KO5NNNC | C1525 | Capacitor_SMD:C_0402_1005Metric | B.Cu | 25.61 | 30.147 |  | pinout/dimensions/sourcing review required | Power distribution; pin-level owner pending | +3V3;GND | Place by datasheet pin/loop requirements after source review; existing coordinates are not approved
C44 | 100nF | CL05B104KO5NNNC | C1525 | Capacitor_SMD:C_0402_1005Metric | B.Cu | 26.218 | 33.593 |  | pinout/dimensions/sourcing review required | Power distribution; pin-level owner pending | GND;UNREG | Place by datasheet pin/loop requirements after source review; existing coordinates are not approved
C45 | 10uF | CL21A106KAYNNNE | C15850 | Capacitor_SMD:C_0805_2012Metric | F.Cu | 14.423 | 21.765 |  | pinout/dimensions/sourcing review required | 3V3 buck | GND;VIN_BK | Place by datasheet pin/loop requirements after source review; existing coordinates are not approved
C46 | 22uF | CL21A226MOQNNNE | C98190 | Capacitor_SMD:C_0805_2012Metric | F.Cu | 27.533 | 2.389 |  | pinout/dimensions/sourcing review required | Power distribution; pin-level owner pending | +3V3;GND | Place by datasheet pin/loop requirements after source review; existing coordinates are not approved
C47 | 10uF | CL21A106KAYNNNE | C15850 | Capacitor_SMD:C_0805_2012Metric | F.Cu | 36.074 | 37.765 |  | pinout/dimensions/sourcing review required | Power distribution; pin-level owner pending | A_IN;GND | Place by datasheet pin/loop requirements after source review; existing coordinates are not approved
C48 | 1uF | CL05A105KA5NQNC | C52923 | Capacitor_SMD:C_0402_1005Metric | B.Cu | 30.5 | 2 |  | pinout/dimensions/sourcing review required | Power distribution; pin-level owner pending | A_IN;GND | Place by datasheet pin/loop requirements after source review; existing coordinates are not approved
C5 | 100nF | CL05B104KO5NNNC | C1525 | Capacitor_SMD:C_0402_1005Metric | B.Cu | 56.65 | 4 |  | pinout/dimensions/sourcing review required | Power distribution; pin-level owner pending | +3V3;GND | Place by datasheet pin/loop requirements after source review; existing coordinates are not approved
C50 | 2.2uF | CL10A226MQ8NRNC | C59461 | Capacitor_SMD:C_0603_1608Metric | F.Cu | 56.5 | 5.5 |  | pinout/dimensions/sourcing review required | Power distribution; pin-level owner pending | A_OUT;GND | Place by datasheet pin/loop requirements after source review; existing coordinates are not approved
C51 | 100nF | CL05B104KO5NNNC | C1525 | Capacitor_SMD:C_0402_1005Metric | B.Cu | 38.389 | 18.591 |  | pinout/dimensions/sourcing review required | Power distribution; pin-level owner pending | +3V3;GND | Place by datasheet pin/loop requirements after source review; existing coordinates are not approved
C52 | 10uF | CL21A106KAYNNNE | C15850 | Capacitor_SMD:C_0805_2012Metric | F.Cu | 31.156 | 15.912 |  | pinout/dimensions/sourcing review required | Power distribution; pin-level owner pending | +3V3;GND | Place by datasheet pin/loop requirements after source review; existing coordinates are not approved
C53 | 100nF | CL05B104KO5NNNC | C1525 | Capacitor_SMD:C_0402_1005Metric | B.Cu | 36.7 | 4 |  | pinout/dimensions/sourcing review required | Power distribution; pin-level owner pending | +3V3A;GND | Place by datasheet pin/loop requirements after source review; existing coordinates are not approved
C54 | 10uF | CL21A106KAYNNNE | C15850 | Capacitor_SMD:C_0805_2012Metric | F.Cu | 62.921 | 18.765 |  | pinout/dimensions/sourcing review required | Power distribution; pin-level owner pending | +3V3A;GND | Place by datasheet pin/loop requirements after source review; existing coordinates are not approved
C55 | 10uF | CL21A106KAYNNNE | C15850 | Capacitor_SMD:C_0805_2012Metric | F.Cu | 56.074 | 34.265 |  | pinout/dimensions/sourcing review required | Audio/codec; pin-level owner pending | CODEC_VCOM;GND | Place by datasheet pin/loop requirements after source review; existing coordinates are not approved
C56 | 22uF | CL31A226KAHNNNE | C12891 | Capacitor_SMD:C_1206_3216Metric | F.Cu | 23.084 | 26.765 |  | pinout/dimensions/sourcing review required | Power distribution; pin-level owner pending | +12V;GND | Place by datasheet pin/loop requirements after source review; existing coordinates are not approved
C57 | 100nF | CL05B104KO5NNNC | C1525 | Capacitor_SMD:C_0402_1005Metric | B.Cu | 28.737 | 10.492 |  | pinout/dimensions/sourcing review required | Power distribution; pin-level owner pending | +12V;GND | Place by datasheet pin/loop requirements after source review; existing coordinates are not approved
C58 | 22uF | CL31A226KAHNNNE | C12891 | Capacitor_SMD:C_1206_3216Metric | F.Cu | 36.074 | 15.765 |  | pinout/dimensions/sourcing review required | Power distribution; pin-level owner pending | -12V;GND | Place by datasheet pin/loop requirements after source review; existing coordinates are not approved
C59 | 100nF | CL05B104KO5NNNC | C1525 | Capacitor_SMD:C_0402_1005Metric | B.Cu | 33.122 | 8.412 |  | pinout/dimensions/sourcing review required | Power distribution; pin-level owner pending | -12V;GND | Place by datasheet pin/loop requirements after source review; existing coordinates are not approved
C6 | 100nF | CL05B104KO5NNNC | C1525 | Capacitor_SMD:C_0402_1005Metric | B.Cu | 53.184 | 15.714 |  | pinout/dimensions/sourcing review required | Power distribution; pin-level owner pending | +3V3;GND | Place by datasheet pin/loop requirements after source review; existing coordinates are not approved
C60 | 10uF | CL21A106KAYNNNE | C15850 | Capacitor_SMD:C_0805_2012Metric | F.Cu | 29.474 | 9.634 |  | pinout/dimensions/sourcing review required | Power distribution; pin-level owner pending | +5V;GND | Place by datasheet pin/loop requirements after source review; existing coordinates are not approved
C61 | 100nF | CL05B104KO5NNNC | C1525 | Capacitor_SMD:C_0402_1005Metric | B.Cu | 9.241 | 13.867 |  | pinout/dimensions/sourcing review required | Power distribution; pin-level owner pending | +5V;GND | Place by datasheet pin/loop requirements after source review; existing coordinates are not approved
C62 | 10uF | CL21A106KAYNNNE | C15850 | Capacitor_SMD:C_0805_2012Metric | F.Cu | 52.574 | 5.686 |  | pinout/dimensions/sourcing review required | Power distribution; pin-level owner pending | +3V3A;GND | Place by datasheet pin/loop requirements after source review; existing coordinates are not approved
C63 | 100nF | CL05B104KO5NNNC | C1525 | Capacitor_SMD:C_0402_1005Metric | B.Cu | 11.118 | 12.292 |  | pinout/dimensions/sourcing review required | Power distribution; pin-level owner pending | GND;LD_IN | Place by datasheet pin/loop requirements after source review; existing coordinates are not approved
C7 | 100nF | CL05B104KO5NNNC | C1525 | Capacitor_SMD:C_0402_1005Metric | B.Cu | 12.995 | 10.717 |  | pinout/dimensions/sourcing review required | Power distribution; pin-level owner pending | +3V3;GND | Place by datasheet pin/loop requirements after source review; existing coordinates are not approved
C8 | 100nF | CL05B104KO5NNNC | C1525 | Capacitor_SMD:C_0402_1005Metric | B.Cu | 14.375 | 15.475 |  | pinout/dimensions/sourcing review required | Power distribution; pin-level owner pending | +3V3;GND | Place by datasheet pin/loop requirements after source review; existing coordinates are not approved
C9 | 100nF | CL05B104KO5NNNC | C1525 | Capacitor_SMD:C_0402_1005Metric | B.Cu | 30.882 | 12.292 |  | pinout/dimensions/sourcing review required | Power distribution; pin-level owner pending | +3V3;GND | Place by datasheet pin/loop requirements after source review; existing coordinates are not approved
D1 | NSR1020 | NSR1020MW2T1G | C116953 | Diode_SMD:D_SOD-923 | F.Cu | 18 | 8 |  | pinout/dimensions/sourcing review required | Input power protection | +12V;INPUT_+12V | Place by datasheet pin/loop requirements after source review; existing coordinates are not approved
D2 | NSR1020 | NSR1020MW2T1G | C116953 | Diode_SMD:D_SOD-923 | F.Cu | 20 | 11 |  | pinout/dimensions/sourcing review required | Input power protection | -12V;INPUT_-12V | Place by datasheet pin/loop requirements after source review; existing coordinates are not approved
D3 | LED_USER | XL-1608SYGC-06 | C965805 | LED_SMD:LED_0603_1608Metric | F.Cu | 4 | 10.5 |  | pinout/dimensions/sourcing review required | User LED | GND;LED_A | Place by datasheet pin/loop requirements after source review; existing coordinates are not approved
D4 | LED_PWR | KT-0603R | C2286 | LED_SMD:LED_0603_1608Metric | F.Cu | 15.5 | 2 |  | pinout/dimensions/sourcing review required | Power LED | GND;PWR_A | Place by datasheet pin/loop requirements after source review; existing coordinates are not approved
D5 | NSR1020 | NSR1020MW2T1G | C116953 | Diode_SMD:D_SOD-923 | F.Cu | 15.871 | 8.483 |  | pinout/dimensions/sourcing review required | USB power protection | +12V;VBUS | Place by datasheet pin/loop requirements after source review; existing coordinates are not approved
FB1 | 600R@100MHz | MCR03EZPFX3600 | C559338 | Inductor_SMD:L_0603_1608Metric | F.Cu | 15.5 | 6 |  | pinout/dimensions/sourcing review required | Power distribution; pin-level owner pending | +3V3A;A_OUT | Place by datasheet pin/loop requirements after source review; existing coordinates are not approved
FB2 | 600R@100MHz | MCR03EZPFX3600 | C559338 | Inductor_SMD:L_0603_1608Metric | F.Cu | 3.233 | 25.465 |  | pinout/dimensions/sourcing review required | 3V3 buck | UNREG;VIN_BK | Place by datasheet pin/loop requirements after source review; existing coordinates are not approved
FB3 | 600R@100MHz | CR0805FR600P05Z | C175716 | Inductor_SMD:L_0805_2012Metric | F.Cu | 55 | 8 |  | pinout/dimensions/sourcing review required | 3V3 buck | +12V;VIN_BK | Place by datasheet pin/loop requirements after source review; existing coordinates are not approved
FB5 | 600R@100MHz | CR0805FR600P05Z | C175716 | Inductor_SMD:L_0805_2012Metric | F.Cu | 23.074 | 11.748 |  | pinout/dimensions/sourcing review required | Power distribution; pin-level owner pending | +3V3;+3V3A | Place by datasheet pin/loop requirements after source review; existing coordinates are not approved
FB7 | 600R@100MHz | CR0805FR600P05Z | C175716 | Inductor_SMD:L_0805_2012Metric | F.Cu | 16 | 4 |  | pinout/dimensions/sourcing review required | Power distribution; pin-level owner pending | +12V;LD_IN | Place by datasheet pin/loop requirements after source review; existing coordinates are not approved
FB8 | 600R@100MHz | CR0805FR600P05Z | C175716 | Inductor_SMD:L_0805_2012Metric | F.Cu | 25.5 | 9.5 |  | pinout/dimensions/sourcing review required | Power distribution; pin-level owner pending | +5V;LD_OUT | Place by datasheet pin/loop requirements after source review; existing coordinates are not approved
FB9 | 600R@100MHz | CR0805FR600P05Z | C175716 | Inductor_SMD:L_0805_2012Metric | B.Cu | 40 | 30.9 |  | pinout/dimensions/sourcing review required | Power distribution; pin-level owner pending | +5V;+5VA | Place by datasheet pin/loop requirements after source review; existing coordinates are not approved
FIDB1 | Fiducial_1mm_Mask2mm |  |  | Fiducial_1mm_Mask2mm | B.Cu | 9.022814 | 2.65414 |  | mechanical fiducial review required | Assembly fiducials |  | Review fiducial count/clearance on both assembly sides
FIDB2 | Fiducial_1mm_Mask2mm |  |  | Fiducial_1mm_Mask2mm | B.Cu | 58 | 30.4 |  | mechanical fiducial review required | Assembly fiducials |  | Review fiducial count/clearance on both assembly sides
FIDF1 | Fiducial_1mm_Mask2mm |  |  | Fiducial_1mm_Mask2mm | F.Cu | 65.38564 | 3.199999 |  | mechanical fiducial review required | Assembly fiducials |  | Review fiducial count/clearance on both assembly sides
FIDF2 | Fiducial_1mm_Mask2mm |  |  | Fiducial_1mm_Mask2mm | F.Cu | 65.38564 | 36.8 |  | mechanical fiducial review required | Assembly fiducials |  | Review fiducial count/clearance on both assembly sides
FIDF3 | Fiducial_1mm_Mask2mm |  |  | Fiducial_1mm_Mask2mm | F.Cu | 3.2 | 37.38564 |  | mechanical fiducial review required | Assembly fiducials |  | Review fiducial count/clearance on both assembly sides
J3 | USB_Micro-B | 10118194-0001LF | C132563 | Connector_USB:USB_Micro-B_Amphenol_10118194-0001LF_Horizontal | F.Cu | 44.279 | 5.682 |  | pinout/dimensions/sourcing review required | USB connector | GND;USB_FS_DM;USB_FS_DP;VBUS;unconnected-(J3-ID-Pad4) | Place by datasheet pin/loop requirements after source review; existing coordinates are not approved
J4 | SWD | SWD062R08E8T | C5151848 | Connector_PinHeader_1.27mm:PinHeader_2x05_P1.27mm_Vertical_SMD | F.Cu | 9.482 | 27.068 |  | pinout/dimensions/sourcing review required | SWD | +3V3;GND;JTDI;NRST;SWCLK;SWDIO;SWO;unconnected-(J4-Pin_7-Pad7) | Place by datasheet pin/loop requirements after source review; existing coordinates are not approved
J5 | PATCH_SM_EDGE |  |  | TeresinaRack:DAISY_PATCH_SM | F.Cu | 34 | 20 |  | pinout/dimensions/sourcing review required | Carrier interface | +3V3;+5V;ADCJACK_10;ADCJACK_11;ADCJACK_12;ADCJACK_9;AUDIO_OUT_L;AUDIO_OUT_R;CVJACK_1;CVJACK_2;CVJACK_3;CVJACK_4;CVJACK_5;CVJACK_6;CVJACK_7;CVJACK_8;CVOUT_1;CVOUT_2;GATEJACK_1;GATEJACK_2;GATEOUT_1;GATEOUT_2;GND;I2C1_SCL;I2C1_SDA;INPUT_+12V;INPUT_-12V;INPUT_AUDIO_LEFT;INPUT_AUDIO_RIGHT;SDMMC1_CK;SDMMC1_CMD;SDMMC1_D0;SDMMC1_D1;SDMMC1_D2;SDMMC1_D3;SPI2_CS;SPI2_SCK;USB_DM;USB_DP | Freeze carrier pad geometry against official drawing
L1 | 2.2uH | NLCV32T-220K-EF | C250233 | Inductor_SMD:L_1210_3225Metric | F.Cu | 9.354 | 11.354 |  | pinout/dimensions/sourcing review required | 3V3 buck | +3V3;SW_BK | Place by datasheet pin/loop requirements after source review; existing coordinates are not approved
Q1 | MMBT3904 | MMBT3904(RANGE:100-300) | C20526 | Package_TO_SOT_SMD:SOT-23 | F.Cu | 36.074 | 34.265 | https://www.onsemi.com/pdf/datasheet/pzt3904-d.pdf | pinout/dimensions/sourcing review required | Gate input | GATE_IN_1;GBASE_1;GND | Place by datasheet pin/loop requirements after source review; existing coordinates are not approved
Q2 | MMBT3904 | MMBT3904(RANGE:100-300) | C20526 | Package_TO_SOT_SMD:SOT-23 | F.Cu | 32.918 | 19.147 | https://www.onsemi.com/pdf/datasheet/pzt3904-d.pdf | pinout/dimensions/sourcing review required | Gate input | GATE_IN_2;GBASE_2;GND | Place by datasheet pin/loop requirements after source review; existing coordinates are not approved
R1 | 4.7k | 0402WGF4701TCE | C25900 | Resistor_SMD:R_0402_1005Metric | F.Cu | 13 | 18 |  | pinout/dimensions/sourcing review required | Power distribution; pin-level owner pending | +3V3;I2C2_SDA | Place by datasheet pin/loop requirements after source review; existing coordinates are not approved
R100 | 66K5 | RC0402FR-0766K5L | C327329 | Resistor_SMD:R_0402_1005Metric | F.Cu | 53.5 | 26 |  | pinout/dimensions/sourcing review required | Power distribution; pin-level owner pending | N_RINA;RINR_M | Place by datasheet pin/loop requirements after source review; existing coordinates are not approved
R101 | 15K | 0402WGF1502TCE | C25756 | Resistor_SMD:R_0402_1005Metric | F.Cu | 24.5 | 5 |  | pinout/dimensions/sourcing review required | Power distribution; pin-level owner pending | RINR_M;RINR_O | Place by datasheet pin/loop requirements after source review; existing coordinates are not approved
R102 | 1K | 0402WGF1001TCE | C11702 | Resistor_SMD:R_0402_1005Metric | F.Cu | 65 | 16 |  | pinout/dimensions/sourcing review required | Audio/codec; pin-level owner pending | CODEC_IN_R;RINR_O | Place by datasheet pin/loop requirements after source review; existing coordinates are not approved
R103 | 66K5 | RC0402FR-0766K5L | C327329 | Resistor_SMD:R_0402_1005Metric | B.Cu | 15.1 | 4 |  | pinout/dimensions/sourcing review required | Power distribution; pin-level owner pending | LINL_M;N_LINA | Place by datasheet pin/loop requirements after source review; existing coordinates are not approved
R104 | 15K | 0402WGF1502TCE | C25756 | Resistor_SMD:R_0402_1005Metric | F.Cu | 36.5 | 19.5 |  | pinout/dimensions/sourcing review required | Power distribution; pin-level owner pending | LINL_M;LINL_O | Place by datasheet pin/loop requirements after source review; existing coordinates are not approved
R105 | 1K | 0402WGF1001TCE | C11702 | Resistor_SMD:R_0402_1005Metric | B.Cu | 24.45 | 4 |  | pinout/dimensions/sourcing review required | Audio/codec; pin-level owner pending | CODEC_IN_L;LINL_O | Place by datasheet pin/loop requirements after source review; existing coordinates are not approved
R11 | 5.1R | 0402WGF510KTCE | C25128 | Resistor_SMD:R_0402_1005Metric | F.Cu | 5 | 22.5 |  | pinout/dimensions/sourcing review required | Power distribution; pin-level owner pending | A_IN;UNREG | Place by datasheet pin/loop requirements after source review; existing coordinates are not approved
R110 | 18K | 0402WGF1802TCE | C25762 | Resistor_SMD:R_0402_1005Metric | B.Cu | 24.715 | 7.118 |  | pinout/dimensions/sourcing review required | Audio/codec; pin-level owner pending | CODEC_OUT_L+;N_OLA | Place by datasheet pin/loop requirements after source review; existing coordinates are not approved
R111 | 66K5 | RC0402FR-0766K5L | C327329 | Resistor_SMD:R_0402_1005Metric | F.Cu | 13 | 15 |  | pinout/dimensions/sourcing review required | Audio/codec; pin-level owner pending | N_OLA;OL_INV | Place by datasheet pin/loop requirements after source review; existing coordinates are not approved
R112 | 39K | 0402WGF3902TCE | C25783 | Resistor_SMD:R_0402_1005Metric | F.Cu | 57 | 10 |  | pinout/dimensions/sourcing review required | Audio/codec; pin-level owner pending | N_OLA;OL_OUT | Place by datasheet pin/loop requirements after source review; existing coordinates are not approved
R113 | 18K | 0402WGF1802TCE | C25762 | Resistor_SMD:R_0402_1005Metric | F.Cu | 56.5 | 36.5 |  | pinout/dimensions/sourcing review required | Audio/codec; pin-level owner pending | CODEC_OUT_L-;N_OLB | Place by datasheet pin/loop requirements after source review; existing coordinates are not approved
R114 | 66K5 | RC0402FR-0766K5L | C327329 | Resistor_SMD:R_0402_1005Metric | B.Cu | 21.85 | 5.472 |  | pinout/dimensions/sourcing review required | Audio/codec; pin-level owner pending | N_OLB;OL_NINV | Place by datasheet pin/loop requirements after source review; existing coordinates are not approved
R115 | 39K | 0402WGF3902TCE | C25783 | Resistor_SMD:R_0402_1005Metric | F.Cu | 36.5 | 18 |  | pinout/dimensions/sourcing review required | Audio/codec; pin-level owner pending | GND;N_OLB | Place by datasheet pin/loop requirements after source review; existing coordinates are not approved
R116 | 100R | RC0402FR-07100RL | C106232 | Resistor_SMD:R_0402_1005Metric | B.Cu | 20.15 | 2.528 |  | pinout/dimensions/sourcing review required | Audio/codec; pin-level owner pending | AUDIO_OUT_L;OL_OUT | Place by datasheet pin/loop requirements after source review; existing coordinates are not approved
R117 | 18K | 0402WGF1802TCE | C25762 | Resistor_SMD:R_0402_1005Metric | B.Cu | 18.357 | 6.218 |  | pinout/dimensions/sourcing review required | Audio/codec; pin-level owner pending | CODEC_OUT_R+;N_ORA | Place by datasheet pin/loop requirements after source review; existing coordinates are not approved
R118 | 66K5 | RC0402FR-0766K5L | C327329 | Resistor_SMD:R_0402_1005Metric | B.Cu | 15.785 | 5.898 |  | pinout/dimensions/sourcing review required | Audio/codec; pin-level owner pending | N_ORA;OR_INV | Place by datasheet pin/loop requirements after source review; existing coordinates are not approved
R119 | 39K | 0402WGF3902TCE | C25783 | Resistor_SMD:R_0402_1005Metric | F.Cu | 15.568 | 13.759 |  | pinout/dimensions/sourcing review required | Audio/codec; pin-level owner pending | N_ORA;OR_OUT | Place by datasheet pin/loop requirements after source review; existing coordinates are not approved
R12 | 47k | 0402WGF4702TCE | C25792 | Resistor_SMD:R_0402_1005Metric | B.Cu | 26.9 | 4 |  | pinout/dimensions/sourcing review required | 3V3 buck | +3V3;FB_BK | Place by datasheet pin/loop requirements after source review; existing coordinates are not approved
R120 | 18K | 0402WGF1802TCE | C25762 | Resistor_SMD:R_0402_1005Metric | F.Cu | 13 | 19.5 |  | pinout/dimensions/sourcing review required | Audio/codec; pin-level owner pending | CODEC_OUT_R-;N_ORB | Place by datasheet pin/loop requirements after source review; existing coordinates are not approved
R121 | 66K5 | RC0402FR-0766K5L | C327329 | Resistor_SMD:R_0402_1005Metric | F.Cu | 62.5 | 24 |  | pinout/dimensions/sourcing review required | Audio/codec; pin-level owner pending | N_ORB;OR_NINV | Place by datasheet pin/loop requirements after source review; existing coordinates are not approved
R122 | 39K | 0402WGF3902TCE | C25783 | Resistor_SMD:R_0402_1005Metric | F.Cu | 55.5 | 31.5 |  | pinout/dimensions/sourcing review required | Audio/codec; pin-level owner pending | GND;N_ORB | Place by datasheet pin/loop requirements after source review; existing coordinates are not approved
R123 | 100R | RC0402FR-07100RL | C106232 | Resistor_SMD:R_0402_1005Metric | B.Cu | 25.229 | 2.461 |  | pinout/dimensions/sourcing review required | Audio/codec; pin-level owner pending | AUDIO_OUT_R;OR_OUT | Place by datasheet pin/loop requirements after source review; existing coordinates are not approved
R124 | 100K | 0402WGF1003TCE | C25741 | Resistor_SMD:R_0402_1005Metric | F.Cu | 53.5 | 11.5 |  | pinout/dimensions/sourcing review required | CV/gate analog; channel owner pending | CVJACK_1;SUM_1 | Place by datasheet pin/loop requirements after source review; existing coordinates are not approved
R125 | 100K | 0402WGF1003TCE | C25741 | Resistor_SMD:R_0402_1005Metric | F.Cu | 65 | 24 |  | pinout/dimensions/sourcing review required | CV/gate analog; channel owner pending | CVJACK_2;SUM_2 | Place by datasheet pin/loop requirements after source review; existing coordinates are not approved
R126 | 100K | 0402WGF1003TCE | C25741 | Resistor_SMD:R_0402_1005Metric | F.Cu | 13 | 13.5 |  | pinout/dimensions/sourcing review required | CV/gate analog; channel owner pending | CVJACK_3;SUM_3 | Place by datasheet pin/loop requirements after source review; existing coordinates are not approved
R127 | 100K | 0402WGF1003TCE | C25741 | Resistor_SMD:R_0402_1005Metric | F.Cu | 7.5 | 22.5 |  | pinout/dimensions/sourcing review required | CV/gate analog; channel owner pending | CVJACK_4;SUM_4 | Place by datasheet pin/loop requirements after source review; existing coordinates are not approved
R128 | 100K | 0402WGF1003TCE | C25741 | Resistor_SMD:R_0402_1005Metric | F.Cu | 17 | 11 |  | pinout/dimensions/sourcing review required | CV/gate analog; channel owner pending | CVJACK_5;SUM_5 | Place by datasheet pin/loop requirements after source review; existing coordinates are not approved
R129 | 100K | 0402WGF1003TCE | C25741 | Resistor_SMD:R_0402_1005Metric | F.Cu | 18.5 | 9.5 |  | pinout/dimensions/sourcing review required | CV/gate analog; channel owner pending | CVJACK_6;SUM_6 | Place by datasheet pin/loop requirements after source review; existing coordinates are not approved
R13 | 15k | 0402WGF1502TCE | C25756 | Resistor_SMD:R_0402_1005Metric | F.Cu | 65 | 22.5 |  | pinout/dimensions/sourcing review required | 3V3 buck | FB_BK;GND | Place by datasheet pin/loop requirements after source review; existing coordinates are not approved
R130 | 100K | 0402WGF1003TCE | C25741 | Resistor_SMD:R_0402_1005Metric | F.Cu | 2.5 | 29 |  | pinout/dimensions/sourcing review required | CV/gate analog; channel owner pending | CVJACK_7;SUM_7 | Place by datasheet pin/loop requirements after source review; existing coordinates are not approved
R131 | 100K | 0402WGF1003TCE | C25741 | Resistor_SMD:R_0402_1005Metric | F.Cu | 15.5 | 15.5 |  | pinout/dimensions/sourcing review required | CV/gate analog; channel owner pending | CVJACK_8;SUM_8 | Place by datasheet pin/loop requirements after source review; existing coordinates are not approved
R132 | 200K | 0402WGF2003TCE | C25764 | Resistor_SMD:R_0402_1005Metric | F.Cu | 54.5 | 10 |  | pinout/dimensions/sourcing review required | CV/gate analog; channel owner pending | SUM_1;VREF_N10 | Place by datasheet pin/loop requirements after source review; existing coordinates are not approved
R133 | 200K | 0402WGF2003TCE | C25764 | Resistor_SMD:R_0402_1005Metric | F.Cu | 33.5 | 2 |  | pinout/dimensions/sourcing review required | CV/gate analog; channel owner pending | SUM_2;VREF_N10 | Place by datasheet pin/loop requirements after source review; existing coordinates are not approved
R134 | 200K | 0402WGF2003TCE | C25764 | Resistor_SMD:R_0402_1005Metric | B.Cu | 18.75 | 7.897 |  | pinout/dimensions/sourcing review required | CV/gate analog; channel owner pending | SUM_3;VREF_N10 | Place by datasheet pin/loop requirements after source review; existing coordinates are not approved
R135 | 200K | 0402WGF2003TCE | C25764 | Resistor_SMD:R_0402_1005Metric | F.Cu | 56 | 11.5 |  | pinout/dimensions/sourcing review required | CV/gate analog; channel owner pending | SUM_4;VREF_N10 | Place by datasheet pin/loop requirements after source review; existing coordinates are not approved
R136 | 200K | 0402WGF2003TCE | C25764 | Resistor_SMD:R_0402_1005Metric | F.Cu | 24.5 | 2 |  | pinout/dimensions/sourcing review required | CV/gate analog; channel owner pending | SUM_5;VREF_N10 | Place by datasheet pin/loop requirements after source review; existing coordinates are not approved
R137 | 200K | 0402WGF2003TCE | C25764 | Resistor_SMD:R_0402_1005Metric | F.Cu | 5 | 12.5 |  | pinout/dimensions/sourcing review required | CV/gate analog; channel owner pending | SUM_6;VREF_N10 | Place by datasheet pin/loop requirements after source review; existing coordinates are not approved
R138 | 200K | 0402WGF2003TCE | C25764 | Resistor_SMD:R_0402_1005Metric | F.Cu | 65 | 21 |  | pinout/dimensions/sourcing review required | CV/gate analog; channel owner pending | SUM_7;VREF_N10 | Place by datasheet pin/loop requirements after source review; existing coordinates are not approved
R139 | 200K | 0402WGF2003TCE | C25764 | Resistor_SMD:R_0402_1005Metric | B.Cu | 17.758 | 2.82 |  | pinout/dimensions/sourcing review required | CV/gate analog; channel owner pending | SUM_8;VREF_N10 | Place by datasheet pin/loop requirements after source review; existing coordinates are not approved
R14 | 1k | 0402WGF1001TCE | C11702 | Resistor_SMD:R_0402_1005Metric | B.Cu | 19.403 | 4.581 |  | pinout/dimensions/sourcing review required | Indicators | LED_A;LED_USER | Place by datasheet pin/loop requirements after source review; existing coordinates are not approved
R140 | 33K | 0402WGF3302TCE | C25779 | Resistor_SMD:R_0402_1005Metric | B.Cu | 21.538 | 7.053 |  | pinout/dimensions/sourcing review required | CV/gate analog; channel owner pending | CV_1;SUM_1 | Place by datasheet pin/loop requirements after source review; existing coordinates are not approved
R141 | 33K | 0402WGF3302TCE | C25779 | Resistor_SMD:R_0402_1005Metric | F.Cu | 62.5 | 16 |  | pinout/dimensions/sourcing review required | CV/gate analog; channel owner pending | CV_2;SUM_2 | Place by datasheet pin/loop requirements after source review; existing coordinates are not approved
R142 | 33K | 0402WGF3302TCE | C25779 | Resistor_SMD:R_0402_1005Metric | F.Cu | 50.5 | 3.5 |  | pinout/dimensions/sourcing review required | CV/gate analog; channel owner pending | CV_3;SUM_3 | Place by datasheet pin/loop requirements after source review; existing coordinates are not approved
R143 | 33K | 0402WGF3302TCE | C25779 | Resistor_SMD:R_0402_1005Metric | F.Cu | 50.5 | 2 |  | pinout/dimensions/sourcing review required | CV/gate analog; channel owner pending | CV_4;SUM_4 | Place by datasheet pin/loop requirements after source review; existing coordinates are not approved
R144 | 33K | 0402WGF3302TCE | C25779 | Resistor_SMD:R_0402_1005Metric | F.Cu | 15.5 | 17 |  | pinout/dimensions/sourcing review required | CV/gate analog; channel owner pending | CV_5;SUM_5 | Place by datasheet pin/loop requirements after source review; existing coordinates are not approved
R145 | 33K | 0402WGF3302TCE | C25779 | Resistor_SMD:R_0402_1005Metric | B.Cu | 17.875 | 9.413 |  | pinout/dimensions/sourcing review required | CV/gate analog; channel owner pending | CV_6;SUM_6 | Place by datasheet pin/loop requirements after source review; existing coordinates are not approved
R146 | 33K | 0402WGF3302TCE | C25779 | Resistor_SMD:R_0402_1005Metric | F.Cu | 54 | 36.5 |  | pinout/dimensions/sourcing review required | CV/gate analog; channel owner pending | CV_7;SUM_7 | Place by datasheet pin/loop requirements after source review; existing coordinates are not approved
R147 | 33K | 0402WGF3302TCE | C25779 | Resistor_SMD:R_0402_1005Metric | F.Cu | 28.296 | 26.487 |  | pinout/dimensions/sourcing review required | CV/gate analog; channel owner pending | CV_8;SUM_8 | Place by datasheet pin/loop requirements after source review; existing coordinates are not approved
R148 | 1K | 0402WGF1001TCE | C11702 | Resistor_SMD:R_0402_1005Metric | F.Cu | 36.074 | 28.765 |  | pinout/dimensions/sourcing review required | Auxiliary ADC | ADCJACK_9;ADC_9 | Place by datasheet pin/loop requirements after source review; existing coordinates are not approved
R149 | 1K | 0402WGF1001TCE | C11702 | Resistor_SMD:R_0402_1005Metric | F.Cu | 10 | 22.5 |  | pinout/dimensions/sourcing review required | Auxiliary ADC | ADCJACK_10;ADC_10 | Place by datasheet pin/loop requirements after source review; existing coordinates are not approved
R15 | 1k | 0402WGF1001TCE | C11702 | Resistor_SMD:R_0402_1005Metric | F.Cu | 26.5 | 11.5 |  | pinout/dimensions/sourcing review required | Indicators | +3V3;PWR_A | Place by datasheet pin/loop requirements after source review; existing coordinates are not approved
R150 | 1K | 0402WGF1001TCE | C11702 | Resistor_SMD:R_0402_1005Metric | F.Cu | 31 | 2 |  | pinout/dimensions/sourcing review required | Auxiliary ADC | ADCJACK_11;ADC_11 | Place by datasheet pin/loop requirements after source review; existing coordinates are not approved
R151 | 1K | 0402WGF1001TCE | C11702 | Resistor_SMD:R_0402_1005Metric | F.Cu | 54 | 38 |  | pinout/dimensions/sourcing review required | Auxiliary ADC | ADCJACK_12;ADC_12 | Place by datasheet pin/loop requirements after source review; existing coordinates are not approved
R152 | 1K | 0402WGF1001TCE | C11702 | Resistor_SMD:R_0402_1005Metric | B.Cu | 25.229 | 5.539 |  | pinout/dimensions/sourcing review required | CV/gate analog; channel owner pending | CVO_FILT_1;CV_OUT_1 | Place by datasheet pin/loop requirements after source review; existing coordinates are not approved
R153 | 1K | 0402WGF1001TCE | C11702 | Resistor_SMD:R_0402_1005Metric | F.Cu | 2.5 | 27.5 |  | pinout/dimensions/sourcing review required | CV/gate analog; channel owner pending | CVO_FILT_2;CV_OUT_2 | Place by datasheet pin/loop requirements after source review; existing coordinates are not approved
R154 | 120K | 0402WGF1203TCE | C25750 | Resistor_SMD:R_0402_1005Metric | F.Cu | 56 | 26 |  | pinout/dimensions/sourcing review required | CV/gate analog; channel owner pending | CVO_FB_1;GND | Place by datasheet pin/loop requirements after source review; existing coordinates are not approved
R155 | 120K | 0402WGF1203TCE | C25750 | Resistor_SMD:R_0402_1005Metric | F.Cu | 15.5 | 24 |  | pinout/dimensions/sourcing review required | CV/gate analog; channel owner pending | CVO_FB_2;GND | Place by datasheet pin/loop requirements after source review; existing coordinates are not approved
R156 | 62K | FRC0402F6202TS | C2909375 | Resistor_SMD:R_0402_1005Metric | F.Cu | 15.5 | 18.5 |  | pinout/dimensions/sourcing review required | CV/gate analog; channel owner pending | CVOUT_1_O;CVO_FB_1 | Place by datasheet pin/loop requirements after source review; existing coordinates are not approved
R157 | 62K | FRC0402F6202TS | C2909375 | Resistor_SMD:R_0402_1005Metric | F.Cu | 24.5 | 3.5 |  | pinout/dimensions/sourcing review required | CV/gate analog; channel owner pending | CVOUT_2_O;CVO_FB_2 | Place by datasheet pin/loop requirements after source review; existing coordinates are not approved
R158 | 100R | RC0402FR-07100RL | C106232 | Resistor_SMD:R_0402_1005Metric | F.Cu | 23.5 | 29 |  | pinout/dimensions/sourcing review required | CV/gate analog; channel owner pending | CVOUT_1;CVOUT_1_O | Place by datasheet pin/loop requirements after source review; existing coordinates are not approved
R159 | 100R | RC0402FR-07100RL | C106232 | Resistor_SMD:R_0402_1005Metric | F.Cu | 13 | 16.5 |  | pinout/dimensions/sourcing review required | CV/gate analog; channel owner pending | CVOUT_2;CVOUT_2_O | Place by datasheet pin/loop requirements after source review; existing coordinates are not approved
R160 | 100K | 0402WGF1003TCE | C25741 | Resistor_SMD:R_0402_1005Metric | F.Cu | 56.5 | 38 |  | pinout/dimensions/sourcing review required | Power distribution; pin-level owner pending | +3V3;VTH | Place by datasheet pin/loop requirements after source review; existing coordinates are not approved
R161 | 100K | 0402WGF1003TCE | C25741 | Resistor_SMD:R_0402_1005Metric | F.Cu | 42.544 | 10.967 |  | pinout/dimensions/sourcing review required | Power distribution; pin-level owner pending | GND;VTH | Place by datasheet pin/loop requirements after source review; existing coordinates are not approved
R162 | 1K | 0402WGF1001TCE | C11702 | Resistor_SMD:R_0402_1005Metric | F.Cu | 3.547 | 1.738 |  | pinout/dimensions/sourcing review required | CV/gate analog; channel owner pending | GATEOUT_1;GATEOUT_1_O | Place by datasheet pin/loop requirements after source review; existing coordinates are not approved
R163 | 1K | 0402WGF1001TCE | C11702 | Resistor_SMD:R_0402_1005Metric | F.Cu | 2.5 | 22.5 |  | pinout/dimensions/sourcing review required | CV/gate analog; channel owner pending | GATEOUT_2;GATEOUT_2_O | Place by datasheet pin/loop requirements after source review; existing coordinates are not approved
R164 | 100K | 0402WGF1003TCE | C25741 | Resistor_SMD:R_0402_1005Metric | B.Cu | 22.839 | 2.457 |  | pinout/dimensions/sourcing review required | CV/gate analog; channel owner pending | GATEJACK_1;GBASE_1 | Place by datasheet pin/loop requirements after source review; existing coordinates are not approved
R165 | 100K | 0402WGF1003TCE | C25741 | Resistor_SMD:R_0402_1005Metric | F.Cu | 2.5 | 12.5 |  | pinout/dimensions/sourcing review required | CV/gate analog; channel owner pending | GATEJACK_2;GBASE_2 | Place by datasheet pin/loop requirements after source review; existing coordinates are not approved
R166 | 1M | 0402WGF1004TCE | C26083 | Resistor_SMD:R_0402_1005Metric | F.Cu | 24.5 | 6.5 |  | pinout/dimensions/sourcing review required | Power distribution; pin-level owner pending | GBASE_1;GND | Place by datasheet pin/loop requirements after source review; existing coordinates are not approved
R167 | 1M | 0402WGF1004TCE | C26083 | Resistor_SMD:R_0402_1005Metric | F.Cu | 30.121 | 12.049 |  | pinout/dimensions/sourcing review required | Power distribution; pin-level owner pending | GBASE_2;GND | Place by datasheet pin/loop requirements after source review; existing coordinates are not approved
R168 | 10K | 0402WGF1002TCE | C72443 | Resistor_SMD:R_0402_1005Metric | B.Cu | 21.842 | 8.776 |  | pinout/dimensions/sourcing review required | CV/gate analog; channel owner pending | +3V3;GATE_IN_1 | Place by datasheet pin/loop requirements after source review; existing coordinates are not approved
R169 | 10K | 0402WGF1002TCE | C72443 | Resistor_SMD:R_0402_1005Metric | F.Cu | 62.5 | 22.5 |  | pinout/dimensions/sourcing review required | CV/gate analog; channel owner pending | +3V3;GATE_IN_2 | Place by datasheet pin/loop requirements after source review; existing coordinates are not approved
R170 | 2K | 0402WGF2001TCE | C4109 | Resistor_SMD:R_0402_1005Metric | F.Cu | 48 | 30 |  | pinout/dimensions/sourcing review required | 10V reference | -12V;VREF_N10 | Place by datasheet pin/loop requirements after source review; existing coordinates are not approved
R2 | 4.7k | 0402WGF4701TCE | C25900 | Resistor_SMD:R_0402_1005Metric | F.Cu | 62.5 | 21 |  | pinout/dimensions/sourcing review required | Power distribution; pin-level owner pending | +3V3;I2C2_SCL | Place by datasheet pin/loop requirements after source review; existing coordinates are not approved
R201 | 4K7 | 0402WGF4701TCE | C25900 | R_0402_1005Metric | F.Cu | 29.35 | 22.31 |  | pinout/dimensions/sourcing review required | Reset/boot | BOOT0;BOOT_FLASH | Place by datasheet pin/loop requirements after source review; existing coordinates are not approved
R202 | 1K | 0402WGF1001TCE | C11702 | Resistor_SMD:R_0402_1005Metric | B.Cu | 23.6 | 13.6 |  | pinout/dimensions/sourcing review required | CV/gate analog; channel owner pending | GATE_IN_1;GATE_IN_1_MCU | Place by datasheet pin/loop requirements after source review; existing coordinates are not approved
R203 | 1K | 0402WGF1001TCE | C11702 | Resistor_SMD:R_0402_1005Metric | B.Cu | 19.8 | 13.2 |  | pinout/dimensions/sourcing review required | CV/gate analog; channel owner pending | GATE_IN_2;GATE_IN_2_MCU | Place by datasheet pin/loop requirements after source review; existing coordinates are not approved
R21 | 10k | 0402WGF1002TCE | C25744 | Resistor_SMD:R_0402_1005Metric | F.Cu | 36.074 | 1.765 |  | pinout/dimensions/sourcing review required | QSPI | +3V3;QSPI_NCS | Place by datasheet pin/loop requirements after source review; existing coordinates are not approved
R3 | 10k | 0402WGF1002TCE | C25744 | Resistor_SMD:R_0402_1005Metric | F.Cu | 51.046 | 30.253 |  | pinout/dimensions/sourcing review required | Reset/boot | +3V3;NRST | Place by datasheet pin/loop requirements after source review; existing coordinates are not approved
R4 | 10k | 0402WGF1002TCE | C25744 | Resistor_SMD:R_0402_1005Metric | B.Cu | 22 | 4 |  | pinout/dimensions/sourcing review required | Reset/boot | BOOT0;GND | Place by datasheet pin/loop requirements after source review; existing coordinates are not approved
SW1 | RESET | KMR231NGLFS | C72443 | Button_Switch_SMD:SW_Push_1P1T_NO_CK_KMR2 | F.Cu | 49.5 | 37 |  | pinout/dimensions/sourcing review required | Reset/boot | GND;NRST | Place by datasheet pin/loop requirements after source review; existing coordinates are not approved
SW2 | BOOT | KMR231NGLFS | C72443 | Button_Switch_SMD:SW_Push_1P1T_NO_CK_KMR2 | F.Cu | 51 | 33 |  | pinout/dimensions/sourcing review required | Reset/boot | +3V3;BOOT0 | Place by datasheet pin/loop requirements after source review; existing coordinates are not approved
U1 | STM32H750IBK6 | STM32H750IBK6 | C730200 | Package_BGA:UFBGA-201_10x10mm_Layout15x15_P0.65mm | F.Cu | 23 | 19 | https://www.st.com/resource/en/datasheet/stm32h750ib.pdf | pinout/dimensions/sourcing review required | MCU | +3V3;+3V3A;ADC_10;ADC_11;ADC_12;ADC_9;BOOT0;BOOT_FLASH;CV_1;CV_2;CV_3;CV_4;CV_5;CV_6;CV_7;CV_8;CV_OUT_1;CV_OUT_2;FMC_A0;FMC_A1;FMC_A10;FMC_A11;FMC_A12;FMC_A2;FMC_A3;FMC_A4;FMC_A5;FMC_A6;FMC_A7;FMC_A8;FMC_A9;FMC_BA0;FMC_BA1;FMC_D0;FMC_D1;FMC_D10;FMC_D11;FMC_D12;FMC_D13;FMC_D14;FMC_D15;FMC_D16;FMC_D17;FMC_D18;FMC_D19;FMC_D2;FMC_D20;FMC_D21;FMC_D22;FMC_D23;FMC_D24;FMC_D25;FMC_D26;FMC_D27;FMC_D28;FMC_D29;FMC_D3;FMC_D30;FMC_D31;FMC_D4;FMC_D5;FMC_D6;FMC_D7;FMC_D8;FMC_D9;FMC_NBL0;FMC_NBL1;FMC_NBL2;FMC_NBL3;FMC_SDCKE0;FMC_SDCLK;FMC_SDNCAS;FMC_SDNE0;FMC_SDNRAS;FMC_SDNWE;GATE_IN_1_MCU;GATE_IN_2_MCU;GATE_OUT_1;GATE_OUT_2;GND;I2C1_SCL;I2C1_SDA;I2C2_SCL;I2C2_SDA;JTDI;LED_USER;NRST;OSC_IN;OSC_OUT;QSPI_CLK;QSPI_IO0;QSPI_IO1;QSPI_IO2;QSPI_IO3;QSPI_NCS;SAI1_FS;SAI1_MCLK;SAI1_SCK;SAI1_SDA;SAI1_SDB;SDMMC1_CK;SDMMC1_CMD;SDMMC1_D0;SDMMC1_D1;SDMMC1_D2;SDMMC1_D3;SPI2_CS;SPI2_SCK;SWCLK;SWDIO;SWO;USB_DM;USB_DP;USB_FS_DM;USB_FS_DP;VCAP;unconnected-(U1-PA10-PadD15);unconnected-(U1-PA8-PadF15);unconnected-(U1-PA9-PadE15);unconnected-(U1-PB0-PadR5);unconnected-(U1-PB12-PadP12);unconnected-(U1-PB13-PadP13);unconnected-(U1-PB2-PadM6);unconnected-(U1-PB5-PadA6);unconnected-(U1-PB6-PadB6);unconnected-(U1-PB7-PadB5);unconnected-(U1-PC15-PadF1);unconnected-(U1-PC5-PadP5);unconnected-(U1-PC6-PadH15);unconnected-(U1-PD11-PadN14);unconnected-(U1-PD12-PadN13);unconnected-(U1-PD13-PadM15);unconnected-(U1-PD4-PadD10);unconnected-(U1-PD5-PadC11);unconnected-(U1-PD6-PadB11);unconnected-(U1-PD7-PadA11);unconnected-(U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 | Place by datasheet pin/loop requirements after source review; existing coordinates are not approved
U12 | TL074 | TL074IDT | C107644 | Package_SO:SOIC-14_3.9x8.7mm_P1.27mm | F.Cu | 57 | 20 | http://www.ti.com/lit/ds/symlink/tl071.pdf | pinout/dimensions/sourcing review required | Audio analog | +12V;-12V;CODEC_VCOM;LINL_M;LINL_O;OL_INV;OL_NINV;OL_OUT;OR_INV;OR_NINV;OR_OUT;RINR_M;RINR_O | Place by datasheet pin/loop requirements after source review; existing coordinates are not approved
U13 | MCP6004 | MCP6004T-I/SL | C7378 | Package_SO:SOIC-14_3.9x8.7mm_P1.27mm | F.Cu | 30 | 33 | http://ww1.microchip.com/downloads/en/DeviceDoc/21733j.pdf | pinout/dimensions/sourcing review required | CV/gate analog | +5V;CV_1;CV_2;CV_3;CV_4;GND;SUM_1;SUM_2;SUM_3;SUM_4 | Place by datasheet pin/loop requirements after source review; existing coordinates are not approved
U14 | MCP6004 | MCP6004T-I/SL | C7378 | Package_SO:SOIC-14_3.9x8.7mm_P1.27mm | F.Cu | 42.5 | 33.866 | http://ww1.microchip.com/downloads/en/DeviceDoc/21733j.pdf | pinout/dimensions/sourcing review required | CV/gate analog | +5V;CV_5;CV_6;CV_7;CV_8;GND;SUM_5;SUM_6;SUM_7;SUM_8 | Place by datasheet pin/loop requirements after source review; existing coordinates are not approved
U15 | MCP6004 | MCP6004T-I/SL | C7378 | Package_SO:SOIC-14_3.9x8.7mm_P1.27mm | F.Cu | 18 | 33 | http://ww1.microchip.com/downloads/en/DeviceDoc/21733j.pdf | pinout/dimensions/sourcing review required | CV/gate analog | +5V;CVOUT_1_O;CVOUT_2_O;CVO_FB_1;CVO_FB_2;CVO_FILT_1;CVO_FILT_2;GATEOUT_1_O;GATEOUT_2_O;GATE_OUT_1;GATE_OUT_2;GND;VTH | Place by datasheet pin/loop requirements after source review; existing coordinates are not approved
U16 | LM4040DBZ-10 | LM4040C10IDBZR | C201738 | Package_TO_SOT_SMD:SOT-23 | F.Cu | 54.5 | 28.67 | http://www.ti.com/lit/ds/symlink/lm4040-n.pdf | pinout/dimensions/sourcing review required | 10V reference | GND;VREF_N10;unconnected-(U16-NC-Pad3) | Place by datasheet pin/loop requirements after source review; existing coordinates are not approved
U2 | IS25LP064A | IS25LP064A-JBLE | C2841348 | Package_SO:SOIC-8_5.3x5.3mm_P1.27mm | F.Cu | 34.388 | 24.551 | https://www.issi.com/WW/pdf/25LP-WP064A.pdf | pinout/dimensions/sourcing review required | QSPI | +3V3;GND;QSPI_CLK;QSPI_IO0;QSPI_IO1;QSPI_IO2;QSPI_IO3;QSPI_NCS | Place by datasheet pin/loop requirements after source review; existing coordinates are not approved
U3 | IS42S32160F-6BLI | IS42S32160F-6BLI | C1348852 | Package_BGA:BGA-90_8.0x13.0mm_Layout2x3x15_P0.8mm | B.Cu | 46 | 20 | https://www.issi.com/WW/pdf/42-45S32160F.pdf | pinout/dimensions/sourcing review required | SDRAM | +3V3;FMC_A0;FMC_A1;FMC_A10;FMC_A11;FMC_A12;FMC_A2;FMC_A3;FMC_A4;FMC_A5;FMC_A6;FMC_A7;FMC_A8;FMC_A9;FMC_BA0;FMC_BA1;FMC_D0;FMC_D1;FMC_D10;FMC_D11;FMC_D12;FMC_D13;FMC_D14;FMC_D15;FMC_D16;FMC_D17;FMC_D18;FMC_D19;FMC_D2;FMC_D20;FMC_D21;FMC_D22;FMC_D23;FMC_D24;FMC_D25;FMC_D26;FMC_D27;FMC_D28;FMC_D29;FMC_D3;FMC_D30;FMC_D31;FMC_D4;FMC_D5;FMC_D6;FMC_D7;FMC_D8;FMC_D9;FMC_NBL0;FMC_NBL1;FMC_NBL2;FMC_NBL3;FMC_SDCKE0;FMC_SDCLK;FMC_SDNCAS;FMC_SDNE0;FMC_SDNRAS;FMC_SDNWE;GND;unconnected-(U3-NC-PadE3);unconnected-(U3-NC-PadE7);unconnected-(U3-NC-PadH7);unconnected-(U3-NC-PadK2);unconnected-(U3-NC-PadK3) | Place by datasheet pin/loop requirements after source review; existing coordinates are not approved
U4 | PCM3060 | PCM3060PWR | C2651841 | Package_SO:TSSOP-28_4.4x9.7mm_P0.65mm | F.Cu | 35.5 | 8 | https://www.ti.com/lit/gpn/pcm3060 | pinout/dimensions/sourcing review required | Codec | +3V3;+5VA;CODEC_IN_L;CODEC_IN_R;CODEC_OUT_L+;CODEC_OUT_L-;CODEC_OUT_R+;CODEC_OUT_R-;CODEC_VCOM;GND;I2C2_SCL;I2C2_SDA;SAI1_FS;SAI1_MCLK;SAI1_SCK;SAI1_SDA;SAI1_SDB;unconnected-(U4-ZEROL-Pad14);unconnected-(U4-ZEROR-Pad13) | Place by datasheet pin/loop requirements after source review; existing coordinates are not approved
U6 | TPS62170DSGR | TPS62170DSGR | C124041 | Package_SON:Texas_DSG0008A_WSON-8-1EP_2x2mm_P0.5mm_EP0.9x1.6mm | F.Cu | 14 | 11 | http://www.ti.com/lit/ds/symlink/tps62170.pdf | pinout/dimensions/sourcing review required | 3V3 buck | +3V3;FB_BK;GND;SW_BK;VIN_BK;unconnected-(U6-PG-Pad8) | Place by datasheet pin/loop requirements after source review; existing coordinates are not approved
U7 | LD1117S50 | LD1117S50CTR | C81157 | Package_TO_SOT_SMD:SOT-223-3_TabPin2 | F.Cu | 7 | 18 | http://www.st.com/st-web-ui/static/active/en/resource/technical/document/datasheet/CD00000544.pdf | pinout/dimensions/sourcing review required | 5V regulator | GND;LD_IN;LD_OUT | Place by datasheet pin/loop requirements after source review; existing coordinates are not approved
U8 | USBLC6-2SC6 | USBLC6-2SC6 | C7519 | Package_TO_SOT_SMD:SOT-23-6 | F.Cu | 21 | 4 | https://www.st.com/resource/en/datasheet/usblc6-2.pdf | pinout/dimensions/sourcing review required | USB protection | GND;USB_FS_DM;USB_FS_DP;VBUS | Place by datasheet pin/loop requirements after source review; existing coordinates are not approved
Y1 | 16MHz | X322516MLB4SI | C13738 | Crystal:Crystal_SMD_3215-2Pin_3.2x1.5mm | F.Cu | 16.768 | 26.768 |  | pinout/dimensions/sourcing review required | HSE clock | OSC_IN;OSC_OUT | Place by datasheet pin/loop requirements after source review; existing coordinates are not approved
