marcoallegretti/Teresina-Rack/docs/review/core-review/ballmap-audit.csv

ref | pin | datasheet_function | symbol_function | symbol_match | schematic_net | pcb_net | net_match | local_x_mm | local_y_mm | x_mm | y_mm
U1 | A1 | PE3 | PE3 | True | /SAI1_SDB | SAI1_SDB | True | -4.55 | -4.55 | 18.45 | 14.45
U1 | A2 | PE2 | PE2 | True | /SAI1_MCLK | SAI1_MCLK | True | -3.9 | -4.55 | 19.1 | 14.45
U1 | A3 | PE1 | PE1 | True | /FMC_NBL1 | FMC_NBL1 | True | -3.25 | -4.55 | 19.75 | 14.45
U1 | A4 | PE0 | PE0 | True | /FMC_NBL0 | FMC_NBL0 | True | -2.6 | -4.55 | 20.4 | 14.45
U1 | A5 | PB8 | PB8 | True | /I2C1_SCL | I2C1_SCL | True | -1.95 | -4.55 | 21.05 | 14.45
U1 | A6 | PB5 | PB5 | True | unconnected-(U1-PB5-PadA6) |  | True | -1.3 | -4.55 | 21.7 | 14.45
U1 | A7 | PG14 | PG14 | True | /GATE_IN_2_MCU | GATE_IN_2_MCU | True | -0.65 | -4.55 | 22.35 | 14.45
U1 | A8 | PG13 | PG13 | True | /GATE_IN_1_MCU | GATE_IN_1_MCU | True | 0.0 | -4.55 | 23.0 | 14.45
U1 | A9 | PB4 | PB4 | True | /SPI2_CS | SPI2_CS | True | 0.65 | -4.55 | 23.65 | 14.45
U1 | A10 | PB3 | PB3 | True | /SWO | SWO | True | 1.3 | -4.55 | 24.3 | 14.45
U1 | A11 | PD7 | PD7 | True | unconnected-(U1-PD7-PadA11) |  | True | 1.95 | -4.55 | 24.95 | 14.45
U1 | A12 | PC12 | PC12 | True | /SDMMC1_CK | SDMMC1_CK | True | 2.6 | -4.55 | 25.6 | 14.45
U1 | A13 | PA15 | PA15 | True | /JTDI | JTDI | True | 3.25 | -4.55 | 26.25 | 14.45
U1 | A14 | PA14 | PA14 | True | /SWCLK | SWCLK | True | 3.9 | -4.55 | 26.9 | 14.45
U1 | A15 | PA13 | PA13 | True | /SWDIO | SWDIO | True | 4.55 | -4.55 | 27.55 | 14.45
U1 | B1 | PE4 | PE4 | True | /SAI1_FS | SAI1_FS | True | -4.55 | -3.9 | 18.45 | 15.1
U1 | B2 | PE5 | PE5 | True | /SAI1_SCK | SAI1_SCK | True | -3.9 | -3.9 | 19.1 | 15.1
U1 | B3 | PE6 | PE6 | True | /SAI1_SDA | SAI1_SDA | True | -3.25 | -3.9 | 19.75 | 15.1
U1 | B4 | PB9 | PB9 | True | /I2C1_SDA | I2C1_SDA | True | -2.6 | -3.9 | 20.4 | 15.1
U1 | B5 | PB7 | PB7 | True | unconnected-(U1-PB7-PadB5) |  | True | -1.95 | -3.9 | 21.05 | 15.1
U1 | B6 | PB6 | PB6 | True | unconnected-(U1-PB6-PadB6) |  | True | -1.3 | -3.9 | 21.7 | 15.1
U1 | B7 | PG15 | PG15 | True | /FMC_SDNCAS | FMC_SDNCAS | True | -0.65 | -3.9 | 22.35 | 15.1
U1 | B8 | PG12 | PG12 | True | unconnected-(U1-PG12-PadB8) |  | True | 0.0 | -3.9 | 23.0 | 15.1
U1 | B9 | PG11 | PG11 | True | unconnected-(U1-PG11-PadB9) |  | True | 0.65 | -3.9 | 23.65 | 15.1
U1 | B10 | PG10 | PG10 | True | unconnected-(U1-PG10-PadB10) |  | True | 1.3 | -3.9 | 24.3 | 15.1
U1 | B11 | PD6 | PD6 | True | unconnected-(U1-PD6-PadB11) |  | True | 1.95 | -3.9 | 24.95 | 15.1
U1 | B12 | PD0 | PD0 | True | /FMC_D2 | FMC_D2 | True | 2.6 | -3.9 | 25.6 | 15.1
U1 | B13 | PC11 | PC11 | True | /SDMMC1_D3 | SDMMC1_D3 | True | 3.25 | -3.9 | 26.25 | 15.1
U1 | B14 | PC10 | PC10 | True | /SDMMC1_D2 | SDMMC1_D2 | True | 3.9 | -3.9 | 26.9 | 15.1
U1 | B15 | PA12 | PA12 | True | /USB_FS_DP | USB_FS_DP | True | 4.55 | -3.9 | 27.55 | 15.1
U1 | C1 | VBAT | VBAT | True | /+3V3 | +3V3 | True | -4.55 | -3.25 | 18.45 | 15.75
U1 | C2 | PI7 | PI7 | True | /FMC_D29 | FMC_D29 | True | -3.9 | -3.25 | 19.1 | 15.75
U1 | C3 | PI6 | PI6 | True | /FMC_D28 | FMC_D28 | True | -3.25 | -3.25 | 19.75 | 15.75
U1 | C4 | PI5 | PI5 | True | /FMC_NBL3 | FMC_NBL3 | True | -2.6 | -3.25 | 20.4 | 15.75
U1 | C5 | VDD | VDD | True | /+3V3 | +3V3 | True | -1.95 | -3.25 | 21.05 | 15.75
U1 | C6 | PDR_ON | PDR_ON | True | /+3V3 | +3V3 | True | -1.3 | -3.25 | 21.7 | 15.75
U1 | C7 | VDD | VDD | True | /+3V3 | +3V3 | True | -0.65 | -3.25 | 22.35 | 15.75
U1 | C8 | VDD | VDD | True | /+3V3 | +3V3 | True | 0.0 | -3.25 | 23.0 | 15.75
U1 | C9 | VDD | VDD | True | /+3V3 | +3V3 | True | 0.65 | -3.25 | 23.65 | 15.75
U1 | C10 | PG9 | PG9 | True | unconnected-(U1-PG9-PadC10) |  | True | 1.3 | -3.25 | 24.3 | 15.75
U1 | C11 | PD5 | PD5 | True | unconnected-(U1-PD5-PadC11) |  | True | 1.95 | -3.25 | 24.95 | 15.75
U1 | C12 | PD1 | PD1 | True | /FMC_D3 | FMC_D3 | True | 2.6 | -3.25 | 25.6 | 15.75
U1 | C13 | PI3 | PI3 | True | /FMC_D27 | FMC_D27 | True | 3.25 | -3.25 | 26.25 | 15.75
U1 | C14 | PI2 | PI2 | True | /FMC_D26 | FMC_D26 | True | 3.9 | -3.25 | 26.9 | 15.75
U1 | C15 | PA11 | PA11 | True | /USB_FS_DM | USB_FS_DM | True | 4.55 | -3.25 | 27.55 | 15.75
U1 | D1 | PC13 | PC13 | True | /GATE_OUT_2 | GATE_OUT_2 | True | -4.55 | -2.6 | 18.45 | 16.4
U1 | D2 | PI8 | PI8 | True | unconnected-(U1-PI8-PadD2) |  | True | -3.9 | -2.6 | 19.1 | 16.4
U1 | D3 | PI9 | PI9 | True | /FMC_D30 | FMC_D30 | True | -3.25 | -2.6 | 19.75 | 16.4
U1 | D4 | PI4 | PI4 | True | /FMC_NBL2 | FMC_NBL2 | True | -2.6 | -2.6 | 20.4 | 16.4
U1 | D5 | VSS | VSS | True | GND | GND | True | -1.95 | -2.6 | 21.05 | 16.4
U1 | D6 | BOOT0 | BOOT0 | True | /BOOT0 | BOOT0 | True | -1.3 | -2.6 | 21.7 | 16.4
U1 | D7 | VSS | VSS | True | GND | GND | True | -0.65 | -2.6 | 22.35 | 16.4
U1 | D8 | VSS | VSS | True | GND | GND | True | 0.0 | -2.6 | 23.0 | 16.4
U1 | D9 | VSS | VSS | True | GND | GND | True | 0.65 | -2.6 | 23.65 | 16.4
U1 | D10 | PD4 | PD4 | True | unconnected-(U1-PD4-PadD10) |  | True | 1.3 | -2.6 | 24.3 | 16.4
U1 | D11 | PD3 | PD3 | True | /SPI2_SCK | SPI2_SCK | True | 1.95 | -2.6 | 24.95 | 16.4
U1 | D12 | PD2 | PD2 | True | /SDMMC1_CMD | SDMMC1_CMD | True | 2.6 | -2.6 | 25.6 | 16.4
U1 | D13 | PH15 | PH15 | True | /FMC_D23 | FMC_D23 | True | 3.25 | -2.6 | 26.25 | 16.4
U1 | D14 | PI1 | PI1 | True | /FMC_D25 | FMC_D25 | True | 3.9 | -2.6 | 26.9 | 16.4
U1 | D15 | PA10 | PA10 | True | unconnected-(U1-PA10-PadD15) |  | True | 4.55 | -2.6 | 27.55 | 16.4
U1 | E1 | PC14 | PC14 | True | /GATE_OUT_1 | GATE_OUT_1 | True | -4.55 | -1.95 | 18.45 | 17.05
U1 | E2 | PF0 | PF0 | True | /FMC_A0 | FMC_A0 | True | -3.9 | -1.95 | 19.1 | 17.05
U1 | E3 | PI10 | PI10 | True | /FMC_D31 | FMC_D31 | True | -3.25 | -1.95 | 19.75 | 17.05
U1 | E4 | PI11 | PI11 | True | unconnected-(U1-PI11-PadE4) |  | True | -2.6 | -1.95 | 20.4 | 17.05
U1 | E12 | PH13 | PH13 | True | /FMC_D21 | FMC_D21 | True | 2.6 | -1.95 | 25.6 | 17.05
U1 | E13 | PH14 | PH14 | True | /FMC_D22 | FMC_D22 | True | 3.25 | -1.95 | 26.25 | 17.05
U1 | E14 | PI0 | PI0 | True | /FMC_D24 | FMC_D24 | True | 3.9 | -1.95 | 26.9 | 17.05
U1 | E15 | PA9 | PA9 | True | unconnected-(U1-PA9-PadE15) |  | True | 4.55 | -1.95 | 27.55 | 17.05
U1 | F1 | PC15 | PC15 | True | unconnected-(U1-PC15-PadF1) |  | True | -4.55 | -1.3 | 18.45 | 17.7
U1 | F2 | VSS | VSS | True | GND | GND | True | -3.9 | -1.3 | 19.1 | 17.7
U1 | F3 | VDD | VDD | True | /+3V3 | +3V3 | True | -3.25 | -1.3 | 19.75 | 17.7
U1 | F4 | PH2 | PH2 | True | /FMC_SDCKE0 | FMC_SDCKE0 | True | -2.6 | -1.3 | 20.4 | 17.7
U1 | F6 | VSS | VSS | True | GND | GND | True | -1.3 | -1.3 | 21.7 | 17.7
U1 | F7 | VSS | VSS | True | GND | GND | True | -0.65 | -1.3 | 22.35 | 17.7
U1 | F8 | VSS | VSS | True | GND | GND | True | 0.0 | -1.3 | 23.0 | 17.7
U1 | F9 | VSS | VSS | True | GND | GND | True | 0.65 | -1.3 | 23.65 | 17.7
U1 | F10 | VSS | VSS | True | GND | GND | True | 1.3 | -1.3 | 24.3 | 17.7
U1 | F12 | VSS | VSS | True | GND | GND | True | 2.6 | -1.3 | 25.6 | 17.7
U1 | F13 | VCAP | VCAP | True | /VCAP | VCAP | True | 3.25 | -1.3 | 26.25 | 17.7
U1 | F14 | PC9 | PC9 | True | /SDMMC1_D1 | SDMMC1_D1 | True | 3.9 | -1.3 | 26.9 | 17.7
U1 | F15 | PA8 | PA8 | True | unconnected-(U1-PA8-PadF15) |  | True | 4.55 | -1.3 | 27.55 | 17.7
U1 | G1 | PH0 | PH0 | True | /OSC_IN | OSC_IN | True | -4.55 | -0.65 | 18.45 | 18.35
U1 | G2 | VSS | VSS | True | GND | GND | True | -3.9 | -0.65 | 19.1 | 18.35
U1 | G3 | VDD | VDD | True | /+3V3 | +3V3 | True | -3.25 | -0.65 | 19.75 | 18.35
U1 | G4 | PH3 | PH3 | True | /FMC_SDNE0 | FMC_SDNE0 | True | -2.6 | -0.65 | 20.4 | 18.35
U1 | G6 | VSS | VSS | True | GND | GND | True | -1.3 | -0.65 | 21.7 | 18.35
U1 | G7 | VSS | VSS | True | GND | GND | True | -0.65 | -0.65 | 22.35 | 18.35
U1 | G8 | VSS | VSS | True | GND | GND | True | 0.0 | -0.65 | 23.0 | 18.35
U1 | G9 | VSS | VSS | True | GND | GND | True | 0.65 | -0.65 | 23.65 | 18.35
U1 | G10 | VSS | VSS | True | GND | GND | True | 1.3 | -0.65 | 24.3 | 18.35
U1 | G12 | VSS | VSS | True | GND | GND | True | 2.6 | -0.65 | 25.6 | 18.35
U1 | G13 | VDD | VDD | True | /+3V3 | +3V3 | True | 3.25 | -0.65 | 26.25 | 18.35
U1 | G14 | PC8 | PC8 | True | /SDMMC1_D0 | SDMMC1_D0 | True | 3.9 | -0.65 | 26.9 | 18.35
U1 | G15 | PC7 | PC7 | True | /LED_USER | LED_USER | True | 4.55 | -0.65 | 27.55 | 18.35
U1 | H1 | PH1 | PH1 | True | /OSC_OUT | OSC_OUT | True | -4.55 | 0.0 | 18.45 | 19.0
U1 | H2 | PF2 | PF2 | True | /FMC_A2 | FMC_A2 | True | -3.9 | 0.0 | 19.1 | 19.0
U1 | H3 | PF1 | PF1 | True | /FMC_A1 | FMC_A1 | True | -3.25 | 0.0 | 19.75 | 19.0
U1 | H4 | PH4 | PH4 | True | unconnected-(U1-PH4-PadH4) |  | True | -2.6 | 0.0 | 20.4 | 19.0
U1 | H6 | VSS | VSS | True | GND | GND | True | -1.3 | 0.0 | 21.7 | 19.0
U1 | H7 | VSS | VSS | True | GND | GND | True | -0.65 | 0.0 | 22.35 | 19.0
U1 | H8 | VSS | VSS | True | GND | GND | True | 0.0 | 0.0 | 23.0 | 19.0
U1 | H9 | VSS | VSS | True | GND | GND | True | 0.65 | 0.0 | 23.65 | 19.0
U1 | H10 | VSS | VSS | True | GND | GND | True | 1.3 | 0.0 | 24.3 | 19.0
U1 | H12 | VSS | VSS | True | GND | GND | True | 2.6 | 0.0 | 25.6 | 19.0
U1 | H13 | VDD33USB | VDD33USB | True | /+3V3 | +3V3 | True | 3.25 | 0.0 | 26.25 | 19.0
U1 | H14 | PG8 | PG8 | True | /FMC_SDCLK | FMC_SDCLK | True | 3.9 | 0.0 | 26.9 | 19.0
U1 | H15 | PC6 | PC6 | True | unconnected-(U1-PC6-PadH15) |  | True | 4.55 | 0.0 | 27.55 | 19.0
U1 | J1 | NRST | NRST | True | /NRST | NRST | True | -4.55 | 0.65 | 18.45 | 19.65
U1 | J2 | PF3 | PF3 | True | /FMC_A3 | FMC_A3 | True | -3.9 | 0.65 | 19.1 | 19.65
U1 | J3 | PF4 | PF4 | True | /FMC_A4 | FMC_A4 | True | -3.25 | 0.65 | 19.75 | 19.65
U1 | J4 | PH5 | PH5 | True | /FMC_SDNWE | FMC_SDNWE | True | -2.6 | 0.65 | 20.4 | 19.65
U1 | J6 | VSS | VSS | True | GND | GND | True | -1.3 | 0.65 | 21.7 | 19.65
U1 | J7 | VSS | VSS | True | GND | GND | True | -0.65 | 0.65 | 22.35 | 19.65
U1 | J8 | VSS | VSS | True | GND | GND | True | 0.0 | 0.65 | 23.0 | 19.65
U1 | J9 | VSS | VSS | True | GND | GND | True | 0.65 | 0.65 | 23.65 | 19.65
U1 | J10 | VSS | VSS | True | GND | GND | True | 1.3 | 0.65 | 24.3 | 19.65
U1 | J12 | VDD | VDD | True | /+3V3 | +3V3 | True | 2.6 | 0.65 | 25.6 | 19.65
U1 | J13 | VDD | VDD | True | /+3V3 | +3V3 | True | 3.25 | 0.65 | 26.25 | 19.65
U1 | J14 | PG7 | PG7 | True | unconnected-(U1-PG7-PadJ14) |  | True | 3.9 | 0.65 | 26.9 | 19.65
U1 | J15 | PG6 | PG6 | True | /QSPI_NCS | QSPI_NCS | True | 4.55 | 0.65 | 27.55 | 19.65
U1 | K1 | PF7 | PF7 | True | /QSPI_IO2 | QSPI_IO2 | True | -4.55 | 1.3 | 18.45 | 20.3
U1 | K2 | PF6 | PF6 | True | /QSPI_IO3 | QSPI_IO3 | True | -3.9 | 1.3 | 19.1 | 20.3
U1 | K3 | PF5 | PF5 | True | /FMC_A5 | FMC_A5 | True | -3.25 | 1.3 | 19.75 | 20.3
U1 | K4 | VDD | VDD | True | /+3V3 | +3V3 | True | -2.6 | 1.3 | 20.4 | 20.3
U1 | K6 | VSS | VSS | True | GND | GND | True | -1.3 | 1.3 | 21.7 | 20.3
U1 | K7 | VSS | VSS | True | GND | GND | True | -0.65 | 1.3 | 22.35 | 20.3
U1 | K8 | VSS | VSS | True | GND | GND | True | 0.0 | 1.3 | 23.0 | 20.3
U1 | K9 | VSS | VSS | True | GND | GND | True | 0.65 | 1.3 | 23.65 | 20.3
U1 | K10 | VSS | VSS | True | GND | GND | True | 1.3 | 1.3 | 24.3 | 20.3
U1 | K12 | PH12 | PH12 | True | /FMC_D20 | FMC_D20 | True | 2.6 | 1.3 | 25.6 | 20.3
U1 | K13 | PG5 | PG5 | True | /FMC_BA1 | FMC_BA1 | True | 3.25 | 1.3 | 26.25 | 20.3
U1 | K14 | PG4 | PG4 | True | /FMC_BA0 | FMC_BA0 | True | 3.9 | 1.3 | 26.9 | 20.3
U1 | K15 | PG3 | PG3 | True | /BOOT_FLASH | BOOT_FLASH | True | 4.55 | 1.3 | 27.55 | 20.3
U1 | L1 | PF10 | PF10 | True | /QSPI_CLK | QSPI_CLK | True | -4.55 | 1.95 | 18.45 | 20.95
U1 | L2 | PF9 | PF9 | True | /QSPI_IO1 | QSPI_IO1 | True | -3.9 | 1.95 | 19.1 | 20.95
U1 | L3 | PF8 | PF8 | True | /QSPI_IO0 | QSPI_IO0 | True | -3.25 | 1.95 | 19.75 | 20.95
U1 | L4 | VSS | VSS | True | GND | GND | True | -2.6 | 1.95 | 20.4 | 20.95
U1 | L12 | PH11 | PH11 | True | /FMC_D19 | FMC_D19 | True | 2.6 | 1.95 | 25.6 | 20.95
U1 | L13 | PH10 | PH10 | True | /FMC_D18 | FMC_D18 | True | 3.25 | 1.95 | 26.25 | 20.95
U1 | L14 | PD15 | PD15 | True | /FMC_D1 | FMC_D1 | True | 3.9 | 1.95 | 26.9 | 20.95
U1 | L15 | PG2 | PG2 | True | /FMC_A12 | FMC_A12 | True | 4.55 | 1.95 | 27.55 | 20.95
U1 | M1 | VSSA | VSSA | True | GND | GND | True | -4.55 | 2.6 | 18.45 | 21.6
U1 | M2 | PC0 | PC0 | True | /CV_7 | CV_7 | True | -3.9 | 2.6 | 19.1 | 21.6
U1 | M3 | PC1 | PC1 | True | /CV_8 | CV_8 | True | -3.25 | 2.6 | 19.75 | 21.6
U1 | M4 | PC2_C | PC2_C | True | /ADC_12 | ADC_12 | True | -2.6 | 2.6 | 20.4 | 21.6
U1 | M5 | PC3_C | PC3_C | True | /ADC_11 | ADC_11 | True | -1.95 | 2.6 | 21.05 | 21.6
U1 | M6 | PB2 | PB2 | True | unconnected-(U1-PB2-PadM6) |  | True | -1.3 | 2.6 | 21.7 | 21.6
U1 | M7 | PG1 | PG1 | True | /FMC_A11 | FMC_A11 | True | -0.65 | 2.6 | 22.35 | 21.6
U1 | M8 | VSS | VSS | True | GND | GND | True | 0.0 | 2.6 | 23.0 | 21.6
U1 | M9 | VSS | VSS | True | GND | GND | True | 0.65 | 2.6 | 23.65 | 21.6
U1 | M10 | VCAP | VCAP | True | /VCAP | VCAP | True | 1.3 | 2.6 | 24.3 | 21.6
U1 | M11 | PH6 | PH6 | True | unconnected-(U1-PH6-PadM11) |  | True | 1.95 | 2.6 | 24.95 | 21.6
U1 | M12 | PH8 | PH8 | True | /FMC_D16 | FMC_D16 | True | 2.6 | 2.6 | 25.6 | 21.6
U1 | M13 | PH9 | PH9 | True | /FMC_D17 | FMC_D17 | True | 3.25 | 2.6 | 26.25 | 21.6
U1 | M14 | PD14 | PD14 | True | /FMC_D0 | FMC_D0 | True | 3.9 | 2.6 | 26.9 | 21.6
U1 | M15 | PD13 | PD13 | True | unconnected-(U1-PD13-PadM15) |  | True | 4.55 | 2.6 | 27.55 | 21.6
U1 | N1 | VREF- | VREF- | True | GND | GND | True | -4.55 | 3.25 | 18.45 | 22.25
U1 | N2 | PA1 | PA1 | True | /ADC_9 | ADC_9 | True | -3.9 | 3.25 | 19.1 | 22.25
U1 | N3 | PA0 | PA0 | True | /ADC_10 | ADC_10 | True | -3.25 | 3.25 | 19.75 | 22.25
U1 | N4 | PA4 | PA4 | True | /CV_OUT_1 | CV_OUT_1 | True | -2.6 | 3.25 | 20.4 | 22.25
U1 | N5 | PC4 | PC4 | True | /CV_6 | CV_6 | True | -1.95 | 3.25 | 21.05 | 22.25
U1 | N6 | PF13 | PF13 | True | /FMC_A7 | FMC_A7 | True | -1.3 | 3.25 | 21.7 | 22.25
U1 | N7 | PG0 | PG0 | True | /FMC_A10 | FMC_A10 | True | -0.65 | 3.25 | 22.35 | 22.25
U1 | N8 | VDD | VDD | True | /+3V3 | +3V3 | True | 0.0 | 3.25 | 23.0 | 22.25
U1 | N9 | VDD | VDD | True | /+3V3 | +3V3 | True | 0.65 | 3.25 | 23.65 | 22.25
U1 | N10 | VDD | VDD | True | /+3V3 | +3V3 | True | 1.3 | 3.25 | 24.3 | 22.25
U1 | N11 | PE13 | PE13 | True | /FMC_D10 | FMC_D10 | True | 1.95 | 3.25 | 24.95 | 22.25
U1 | N12 | PH7 | PH7 | True | unconnected-(U1-PH7-PadN12) |  | True | 2.6 | 3.25 | 25.6 | 22.25
U1 | N13 | PD12 | PD12 | True | unconnected-(U1-PD12-PadN13) |  | True | 3.25 | 3.25 | 26.25 | 22.25
U1 | N14 | PD11 | PD11 | True | unconnected-(U1-PD11-PadN14) |  | True | 3.9 | 3.25 | 26.9 | 22.25
U1 | N15 | PD10 | PD10 | True | /FMC_D15 | FMC_D15 | True | 4.55 | 3.25 | 27.55 | 22.25
U1 | P1 | VREF+ | VREF+ | True | /+3V3A | +3V3A | True | -4.55 | 3.9 | 18.45 | 22.9
U1 | P2 | PA2 | PA2 | True | /CV_3 | CV_3 | True | -3.9 | 3.9 | 19.1 | 22.9
U1 | P3 | PA6 | PA6 | True | /CV_2 | CV_2 | True | -3.25 | 3.9 | 19.75 | 22.9
U1 | P4 | PA5 | PA5 | True | /CV_OUT_2 | CV_OUT_2 | True | -2.6 | 3.9 | 20.4 | 22.9
U1 | P5 | PC5 | PC5 | True | unconnected-(U1-PC5-PadP5) |  | True | -1.95 | 3.9 | 21.05 | 22.9
U1 | P6 | PF12 | PF12 | True | /FMC_A6 | FMC_A6 | True | -1.3 | 3.9 | 21.7 | 22.9
U1 | P7 | PF15 | PF15 | True | /FMC_A9 | FMC_A9 | True | -0.65 | 3.9 | 22.35 | 22.9
U1 | P8 | PE8 | PE8 | True | /FMC_D5 | FMC_D5 | True | 0.0 | 3.9 | 23.0 | 22.9
U1 | P9 | PE9 | PE9 | True | /FMC_D6 | FMC_D6 | True | 0.65 | 3.9 | 23.65 | 22.9
U1 | P10 | PE11 | PE11 | True | /FMC_D8 | FMC_D8 | True | 1.3 | 3.9 | 24.3 | 22.9
U1 | P11 | PE14 | PE14 | True | /FMC_D11 | FMC_D11 | True | 1.95 | 3.9 | 24.95 | 22.9
U1 | P12 | PB12 | PB12 | True | unconnected-(U1-PB12-PadP12) |  | True | 2.6 | 3.9 | 25.6 | 22.9
U1 | P13 | PB13 | PB13 | True | unconnected-(U1-PB13-PadP13) |  | True | 3.25 | 3.9 | 26.25 | 22.9
U1 | P14 | PD9 | PD9 | True | /FMC_D14 | FMC_D14 | True | 3.9 | 3.9 | 26.9 | 22.9
U1 | P15 | PD8 | PD8 | True | /FMC_D13 | FMC_D13 | True | 4.55 | 3.9 | 27.55 | 22.9
U1 | R1 | VDDA | VDDA | True | /+3V3A | +3V3A | True | -4.55 | 4.55 | 18.45 | 23.55
U1 | R2 | PA3 | PA3 | True | /CV_1 | CV_1 | True | -3.9 | 4.55 | 19.1 | 23.55
U1 | R3 | PA7 | PA7 | True | /CV_4 | CV_4 | True | -3.25 | 4.55 | 19.75 | 23.55
U1 | R4 | PB1 | PB1 | True | /CV_5 | CV_5 | True | -2.6 | 4.55 | 20.4 | 23.55
U1 | R5 | PB0 | PB0 | True | unconnected-(U1-PB0-PadR5) |  | True | -1.95 | 4.55 | 21.05 | 23.55
U1 | R6 | PF11 | PF11 | True | /FMC_SDNRAS | FMC_SDNRAS | True | -1.3 | 4.55 | 21.7 | 23.55
U1 | R7 | PF14 | PF14 | True | /FMC_A8 | FMC_A8 | True | -0.65 | 4.55 | 22.35 | 23.55
U1 | R8 | PE7 | PE7 | True | /FMC_D4 | FMC_D4 | True | 0.0 | 4.55 | 23.0 | 23.55
U1 | R9 | PE10 | PE10 | True | /FMC_D7 | FMC_D7 | True | 0.65 | 4.55 | 23.65 | 23.55
U1 | R10 | PE12 | PE12 | True | /FMC_D9 | FMC_D9 | True | 1.3 | 4.55 | 24.3 | 23.55
U1 | R11 | PE15 | PE15 | True | /FMC_D12 | FMC_D12 | True | 1.95 | 4.55 | 24.95 | 23.55
U1 | R12 | PB10 | PB10 | True | /I2C2_SCL | I2C2_SCL | True | 2.6 | 4.55 | 25.6 | 23.55
U1 | R13 | PB11 | PB11 | True | /I2C2_SDA | I2C2_SDA | True | 3.25 | 4.55 | 26.25 | 23.55
U1 | R14 | PB14 | PB14 | True | /USB_DM | USB_DM | True | 3.9 | 4.55 | 26.9 | 23.55
U1 | R15 | PB15 | PB15 | True | /USB_DP | USB_DP | True | 4.55 | 4.55 | 27.55 | 23.55
U3 | A1 | DQ26 | DQ26 | True | /FMC_D26 | FMC_D26 | True | -3.2 | 5.6 | 49.2 | 14.4
U3 | A2 | DQ24 | DQ24 | True | /FMC_D24 | FMC_D24 | True | -2.4 | 5.6 | 48.4 | 14.4
U3 | A3 | VSS | VSS | True | GND | GND | True | -1.6 | 5.6 | 47.6 | 14.4
U3 | A7 | VDD | VDD | True | /+3V3 | +3V3 | True | 1.6 | 5.6 | 44.4 | 14.4
U3 | A8 | DQ23 | DQ23 | True | /FMC_D23 | FMC_D23 | True | 2.4 | 5.6 | 43.6 | 14.4
U3 | A9 | DQ21 | DQ21 | True | /FMC_D21 | FMC_D21 | True | 3.2 | 5.6 | 42.8 | 14.4
U3 | B1 | DQ28 | DQ28 | True | /FMC_D28 | FMC_D28 | True | -3.2 | 4.8 | 49.2 | 15.2
U3 | B2 | VDDQ | VDDQ | True | /+3V3 | +3V3 | True | -2.4 | 4.8 | 48.4 | 15.2
U3 | B3 | VSSQ | VSSQ | True | GND | GND | True | -1.6 | 4.8 | 47.6 | 15.2
U3 | B7 | VDDQ | VDDQ | True | /+3V3 | +3V3 | True | 1.6 | 4.8 | 44.4 | 15.2
U3 | B8 | VSSQ | VSSQ | True | GND | GND | True | 2.4 | 4.8 | 43.6 | 15.2
U3 | B9 | DQ19 | DQ19 | True | /FMC_D19 | FMC_D19 | True | 3.2 | 4.8 | 42.8 | 15.2
U3 | C1 | VSSQ | VSSQ | True | GND | GND | True | -3.2 | 4.0 | 49.2 | 16.0
U3 | C2 | DQ27 | DQ27 | True | /FMC_D27 | FMC_D27 | True | -2.4 | 4.0 | 48.4 | 16.0
U3 | C3 | DQ25 | DQ25 | True | /FMC_D25 | FMC_D25 | True | -1.6 | 4.0 | 47.6 | 16.0
U3 | C7 | DQ22 | DQ22 | True | /FMC_D22 | FMC_D22 | True | 1.6 | 4.0 | 44.4 | 16.0
U3 | C8 | DQ20 | DQ20 | True | /FMC_D20 | FMC_D20 | True | 2.4 | 4.0 | 43.6 | 16.0
U3 | C9 | VDDQ | VDDQ | True | /+3V3 | +3V3 | True | 3.2 | 4.0 | 42.8 | 16.0
U3 | D1 | VSSQ | VSSQ | True | GND | GND | True | -3.2 | 3.2 | 49.2 | 16.8
U3 | D2 | DQ29 | DQ29 | True | /FMC_D29 | FMC_D29 | True | -2.4 | 3.2 | 48.4 | 16.8
U3 | D3 | DQ30 | DQ30 | True | /FMC_D30 | FMC_D30 | True | -1.6 | 3.2 | 47.6 | 16.8
U3 | D7 | DQ17 | DQ17 | True | /FMC_D17 | FMC_D17 | True | 1.6 | 3.2 | 44.4 | 16.8
U3 | D8 | DQ18 | DQ18 | True | /FMC_D18 | FMC_D18 | True | 2.4 | 3.2 | 43.6 | 16.8
U3 | D9 | VDDQ | VDDQ | True | /+3V3 | +3V3 | True | 3.2 | 3.2 | 42.8 | 16.8
U3 | E1 | VDDQ | VDDQ | True | /+3V3 | +3V3 | True | -3.2 | 2.4 | 49.2 | 17.6
U3 | E2 | DQ31 | DQ31 | True | /FMC_D31 | FMC_D31 | True | -2.4 | 2.4 | 48.4 | 17.6
U3 | E3 | NC | NC | True | unconnected-(U3-NC-PadE3) | NC_U3_E3 | True | -1.6 | 2.4 | 47.6 | 17.6
U3 | E7 | NC | NC | True | unconnected-(U3-NC-PadE7) | NC_U3_E7 | True | 1.6 | 2.4 | 44.4 | 17.6
U3 | E8 | DQ16 | DQ16 | True | /FMC_D16 | FMC_D16 | True | 2.4 | 2.4 | 43.6 | 17.6
U3 | E9 | VSSQ | VSSQ | True | GND | GND | True | 3.2 | 2.4 | 42.8 | 17.6
U3 | F1 | VSS | VSS | True | GND | GND | True | -3.2 | 1.6 | 49.2 | 18.4
U3 | F2 | DQM3 | DQM3 | True | /FMC_NBL3 | FMC_NBL3 | True | -2.4 | 1.6 | 48.4 | 18.4
U3 | F3 | A3 | A3 | True | /FMC_A3 | FMC_A3 | True | -1.6 | 1.6 | 47.6 | 18.4
U3 | F7 | A2 | A2 | True | /FMC_A2 | FMC_A2 | True | 1.6 | 1.6 | 44.4 | 18.4
U3 | F8 | DQM2 | DQM2 | True | /FMC_NBL2 | FMC_NBL2 | True | 2.4 | 1.6 | 43.6 | 18.4
U3 | F9 | VDD | VDD | True | /+3V3 | +3V3 | True | 3.2 | 1.6 | 42.8 | 18.4
U3 | G1 | A4 | A4 | True | /FMC_A4 | FMC_A4 | True | -3.2 | 0.8 | 49.2 | 19.2
U3 | G2 | A5 | A5 | True | /FMC_A5 | FMC_A5 | True | -2.4 | 0.8 | 48.4 | 19.2
U3 | G3 | A6 | A6 | True | /FMC_A6 | FMC_A6 | True | -1.6 | 0.8 | 47.6 | 19.2
U3 | G7 | A10 | A10 | True | /FMC_A10 | FMC_A10 | True | 1.6 | 0.8 | 44.4 | 19.2
U3 | G8 | A0 | A0 | True | /FMC_A0 | FMC_A0 | True | 2.4 | 0.8 | 43.6 | 19.2
U3 | G9 | A1 | A1 | True | /FMC_A1 | FMC_A1 | True | 3.2 | 0.8 | 42.8 | 19.2
U3 | H1 | A7 | A7 | True | /FMC_A7 | FMC_A7 | True | -3.2 | 0.0 | 49.2 | 20.0
U3 | H2 | A8 | A8 | True | /FMC_A8 | FMC_A8 | True | -2.4 | 0.0 | 48.4 | 20.0
U3 | H3 | A12 | A12 | True | /FMC_A12 | FMC_A12 | True | -1.6 | 0.0 | 47.6 | 20.0
U3 | H7 | NC | NC | True | unconnected-(U3-NC-PadH7) | NC_U3_H7 | True | 1.6 | 0.0 | 44.4 | 20.0
U3 | H8 | BA1 | BA1 | True | /FMC_BA1 | FMC_BA1 | True | 2.4 | 0.0 | 43.6 | 20.0
U3 | H9 | A11 | A11 | True | /FMC_A11 | FMC_A11 | True | 3.2 | 0.0 | 42.8 | 20.0
U3 | J1 | CLK | CLK | True | /FMC_SDCLK | FMC_SDCLK | True | -3.2 | -0.8 | 49.2 | 20.8
U3 | J2 | CKE | CKE | True | /FMC_SDCKE0 | FMC_SDCKE0 | True | -2.4 | -0.8 | 48.4 | 20.8
U3 | J3 | A9 | A9 | True | /FMC_A9 | FMC_A9 | True | -1.6 | -0.8 | 47.6 | 20.8
U3 | J7 | BA0 | BA0 | True | /FMC_BA0 | FMC_BA0 | True | 1.6 | -0.8 | 44.4 | 20.8
U3 | J8 | CS | CS | True | /FMC_SDNE0 | FMC_SDNE0 | True | 2.4 | -0.8 | 43.6 | 20.8
U3 | J9 | RAS | RAS | True | /FMC_SDNRAS | FMC_SDNRAS | True | 3.2 | -0.8 | 42.8 | 20.8
U3 | K1 | DQM1 | DQM1 | True | /FMC_NBL1 | FMC_NBL1 | True | -3.2 | -1.6 | 49.2 | 21.6
U3 | K2 | NC | NC | True | unconnected-(U3-NC-PadK2) | NC_U3_K2 | True | -2.4 | -1.6 | 48.4 | 21.6
U3 | K3 | NC | NC | True | unconnected-(U3-NC-PadK3) | NC_U3_K3 | True | -1.6 | -1.6 | 47.6 | 21.6
U3 | K7 | CAS | CAS | True | /FMC_SDNCAS | FMC_SDNCAS | True | 1.6 | -1.6 | 44.4 | 21.6
U3 | K8 | WE | WE | True | /FMC_SDNWE | FMC_SDNWE | True | 2.4 | -1.6 | 43.6 | 21.6
U3 | K9 | DQM0 | DQM0 | True | /FMC_NBL0 | FMC_NBL0 | True | 3.2 | -1.6 | 42.8 | 21.6
U3 | L1 | VDDQ | VDDQ | True | /+3V3 | +3V3 | True | -3.2 | -2.4 | 49.2 | 22.4
U3 | L2 | DQ8 | DQ8 | True | /FMC_D8 | FMC_D8 | True | -2.4 | -2.4 | 48.4 | 22.4
U3 | L3 | VSS | VSS | True | GND | GND | True | -1.6 | -2.4 | 47.6 | 22.4
U3 | L7 | VDD | VDD | True | /+3V3 | +3V3 | True | 1.6 | -2.4 | 44.4 | 22.4
U3 | L8 | DQ7 | DQ7 | True | /FMC_D7 | FMC_D7 | True | 2.4 | -2.4 | 43.6 | 22.4
U3 | L9 | VSSQ | VSSQ | True | GND | GND | True | 3.2 | -2.4 | 42.8 | 22.4
U3 | M1 | VSSQ | VSSQ | True | GND | GND | True | -3.2 | -3.2 | 49.2 | 23.2
U3 | M2 | DQ10 | DQ10 | True | /FMC_D10 | FMC_D10 | True | -2.4 | -3.2 | 48.4 | 23.2
U3 | M3 | DQ9 | DQ9 | True | /FMC_D9 | FMC_D9 | True | -1.6 | -3.2 | 47.6 | 23.2
U3 | M7 | DQ6 | DQ6 | True | /FMC_D6 | FMC_D6 | True | 1.6 | -3.2 | 44.4 | 23.2
U3 | M8 | DQ5 | DQ5 | True | /FMC_D5 | FMC_D5 | True | 2.4 | -3.2 | 43.6 | 23.2
U3 | M9 | VDDQ | VDDQ | True | /+3V3 | +3V3 | True | 3.2 | -3.2 | 42.8 | 23.2
U3 | N1 | VSSQ | VSSQ | True | GND | GND | True | -3.2 | -4.0 | 49.2 | 24.0
U3 | N2 | DQ12 | DQ12 | True | /FMC_D12 | FMC_D12 | True | -2.4 | -4.0 | 48.4 | 24.0
U3 | N3 | DQ14 | DQ14 | True | /FMC_D14 | FMC_D14 | True | -1.6 | -4.0 | 47.6 | 24.0
U3 | N7 | DQ1 | DQ1 | True | /FMC_D1 | FMC_D1 | True | 1.6 | -4.0 | 44.4 | 24.0
U3 | N8 | DQ3 | DQ3 | True | /FMC_D3 | FMC_D3 | True | 2.4 | -4.0 | 43.6 | 24.0
U3 | N9 | VDDQ | VDDQ | True | /+3V3 | +3V3 | True | 3.2 | -4.0 | 42.8 | 24.0
U3 | P1 | DQ11 | DQ11 | True | /FMC_D11 | FMC_D11 | True | -3.2 | -4.8 | 49.2 | 24.8
U3 | P2 | VDDQ | VDDQ | True | /+3V3 | +3V3 | True | -2.4 | -4.8 | 48.4 | 24.8
U3 | P3 | VSSQ | VSSQ | True | GND | GND | True | -1.6 | -4.8 | 47.6 | 24.8
U3 | P7 | VDDQ | VDDQ | True | /+3V3 | +3V3 | True | 1.6 | -4.8 | 44.4 | 24.8
U3 | P8 | VSSQ | VSSQ | True | GND | GND | True | 2.4 | -4.8 | 43.6 | 24.8
U3 | P9 | DQ4 | DQ4 | True | /FMC_D4 | FMC_D4 | True | 3.2 | -4.8 | 42.8 | 24.8
U3 | R1 | DQ13 | DQ13 | True | /FMC_D13 | FMC_D13 | True | -3.2 | -5.6 | 49.2 | 25.6
U3 | R2 | DQ15 | DQ15 | True | /FMC_D15 | FMC_D15 | True | -2.4 | -5.6 | 48.4 | 25.6
U3 | R3 | VSS | VSS | True | GND | GND | True | -1.6 | -5.6 | 47.6 | 25.6
U3 | R7 | VDD | VDD | True | /+3V3 | +3V3 | True | 1.6 | -5.6 | 44.4 | 25.6
U3 | R8 | DQ0 | DQ0 | True | /FMC_D0 | FMC_D0 | True | 2.4 | -5.6 | 43.6 | 25.6
U3 | R9 | DQ2 | DQ2 | True | /FMC_D2 | FMC_D2 | True | 3.2 | -5.6 | 42.8 | 25.6
U2 | 1 | CE | CE | True | /QSPI_NCS | QSPI_NCS | True | -3.5875 | -1.905 | 30.8005 | 22.646
U2 | 2 | IO1 | IO1 | True | /QSPI_IO1 | QSPI_IO1 | True | -3.5875 | -0.635 | 30.8005 | 23.916
U2 | 3 | IO2 | IO2 | True | /QSPI_IO2 | QSPI_IO2 | True | -3.5875 | 0.635 | 30.8005 | 25.186
U2 | 4 | GND | GND | True | GND | GND | True | -3.5875 | 1.905 | 30.8005 | 26.456
U2 | 5 | IO0 | IO0 | True | /QSPI_IO0 | QSPI_IO0 | True | 3.5875 | 1.905 | 37.9755 | 26.456
U2 | 6 | SCK | SCK | True | /QSPI_CLK | QSPI_CLK | True | 3.5875 | 0.635 | 37.9755 | 25.186
U2 | 7 | IO3 | IO3 | True | /QSPI_IO3 | QSPI_IO3 | True | 3.5875 | -0.635 | 37.9755 | 23.916
U2 | 8 | VCC | VCC | True | /+3V3 | +3V3 | True | 3.5875 | -1.905 | 37.9755 | 22.646
