marcoallegretti/Teresina-Rack/TeresinaRack/TeresinaRack.kicad_pcb

## KiCad design TeresinaRack/TeresinaRack.kicad_pcb (2026-07-21)

Schematic: TeresinaRack.kicad_sch

Parts:
C1, C2, C3, C4, C5, C6, C7, C8, C9, C10, C16, C18, C19, C20, C21, C22, C23, C24, C25, C26, C29, C30, C31, C32, C39, C44, C51, C53, C57, C59, C61, C63, C102, C105, C112, C113, C140, C141, C142, C143, C204, C205, C206, C207: 100nF; C_0402_1005Metric; MPN CL05B104KO5NNNC; LCSC C1525
C11, C12, C27, C28: 4.7uF; C_0805_2012Metric; MPN CL21A475KAQNNNE; LCSC C1779
C13, C14, C50: 2.2uF; C_0603_1608Metric; MPN CL10A226MQ8NRNC; LCSC C59461
C15, C17, C48: 1uF; C_0402_1005Metric; MPN CL05A105KA5NQNC; LCSC C52923
C34, C35, C45, C47, C52, C54, C55, C60, C62: 10uF; C_0805_2012Metric; MPN CL21A106KAYNNNE; LCSC C15850
C36, C46: 22uF; C_0805_2012Metric; MPN CL21A226MOQNNNE; LCSC C98190
C37, C38, C120, C122, C123, C125: 18pF; C_0402_1005Metric; MPN 0402CG180J500NT; LCSC C1549
C56, C58: 22uF; C_1206_3216Metric; MPN CL31A226KAHNNNE; LCSC C12891
C100, C103: 2.2uF; C_0805_2012Metric; MPN CL21A226MAQNNNE; LCSC C45783
C101, C104, C126, C127, C128, C129, C130, C131, C132, C133: 220pF; C_0402_1005Metric; MPN 0402B221K500NT; LCSC C1530
C121, C124: 100pF; C_0402_1005Metric; MPN 0402CG101J500NT; LCSC C1546
C134, C135, C136, C137, C138, C139: 1nF; C_0402_1005Metric; MPN 0402B102K500NT; LCSC C1523
C201: 2.2uF; C_0603_1608Metric; MPN CL10A225KO8NNNC; LCSC C23630
C202: 100nF; C_0402_1005Metric
C203: 10uF; C_0805_2012Metric
D1, D2, D5: NSR1020; D_SOD-923; MPN NSR1020MW2T1G; LCSC C116953
D3: LED_USER; LED_0603_1608Metric; MPN XL-1608SYGC-06; LCSC C965805
D4: LED_PWR; LED_0603_1608Metric; MPN KT-0603R; LCSC C2286
FB1, FB2: 600R@100MHz; L_0603_1608Metric; MPN MCR03EZPFX3600; LCSC C559338
FB3, FB5, FB7, FB8: 600R@100MHz; L_0805_2012Metric; MPN CR0805FR600P05Z; LCSC C175716
FB9: 600R@100MHz; L_0805_2012Metric
J3: USB_Micro-B; USB_Micro-B_Amphenol_10118194-0001LF_Horizontal; MPN 10118194-0001LF; LCSC C132563
J4: SWD; PinHeader_2x05_P1.27mm_Vertical_SMD; MPN SWD062R08E8T; LCSC C5151848
J5: PATCH_SM_EDGE; DAISY_PATCH_SM
L1: 2.2uH; L_1210_3225Metric; MPN NLCV32T-220K-EF; LCSC C250233
Q1, Q2: MMBT3904; SOT-23; MPN MMBT3904(RANGE:100-300); LCSC C20526
R1, R2: 4.7k; R_0402_1005Metric; MPN 0402WGF4701TCE; LCSC C25900
R3, R4, R21: 10k; R_0402_1005Metric; MPN 0402WGF1002TCE; LCSC C25744
R11: 5.1R; R_0402_1005Metric; MPN 0402WGF510KTCE; LCSC C25128
R12: 47k; R_0402_1005Metric; MPN 0402WGF4702TCE; LCSC C25792
R13: 15k; R_0402_1005Metric; MPN 0402WGF1502TCE; LCSC C25756
R14, R15: 1k; R_0402_1005Metric; MPN 0402WGF1001TCE; LCSC C11702
R100, R103, R111, R114, R118, R121: 66K5; R_0402_1005Metric; MPN RC0402FR-0766K5L; LCSC C327329
R101, R104: 15K; R_0402_1005Metric; MPN 0402WGF1502TCE; LCSC C25756
R102, R105, R148, R149, R150, R151, R152, R153, R162, R163, R202, R203: 1K; R_0402_1005Metric; MPN 0402WGF1001TCE; LCSC C11702
R110, R113, R117, R120: 18K; R_0402_1005Metric; MPN 0402WGF1802TCE; LCSC C25762
R112, R115, R119, R122: 39K; R_0402_1005Metric; MPN 0402WGF3902TCE; LCSC C25783
R116, R123, R158, R159: 100R; R_0402_1005Metric; MPN RC0402FR-07100RL; LCSC C106232
R124, R125, R126, R127, R128, R129, R130, R131, R160, R161, R164, R165: 100K; R_0402_1005Metric; MPN 0402WGF1003TCE; LCSC C25741
R132, R133, R134, R135, R136, R137, R138, R139: 200K; R_0402_1005Metric; MPN 0402WGF2003TCE; LCSC C25764
R140, R141, R142, R143, R144, R145, R146, R147: 33K; R_0402_1005Metric; MPN 0402WGF3302TCE; LCSC C25779
R154, R155: 120K; R_0402_1005Metric; MPN 0402WGF1203TCE; LCSC C25750
R156, R157: 62K; R_0402_1005Metric; MPN FRC0402F6202TS; LCSC C2909375
R166, R167: 1M; R_0402_1005Metric; MPN 0402WGF1004TCE; LCSC C26083
R168, R169: 10K; R_0402_1005Metric; MPN 0402WGF1002TCE; LCSC C72443
R170: 2K; R_0402_1005Metric; MPN 0402WGF2001TCE; LCSC C4109
R201: 4K7; R_0402_1005Metric; MPN 0402WGF4701TCE; LCSC C25900
SW1: RESET; SW_Push_1P1T_NO_CK_KMR2; MPN KMR231NGLFS; LCSC C72443
SW2: BOOT; SW_Push_1P1T_NO_CK_KMR2; MPN KMR231NGLFS; LCSC C72443
U1: STM32H750IBK6; UFBGA-201_10x10mm_Layout15x15_P0.65mm; MPN STM32H750IBK6; LCSC C730200
U2: IS25LP064A; SOIC-8_5.3x5.3mm_P1.27mm; MPN IS25LP064A-JBLE; LCSC C2841348
U3: IS42S32160F-6BLI; BGA-90_8.0x13.0mm_Layout2x3x15_P0.8mm; MPN IS42S32160F-6BLI; LCSC C1348852
U4: PCM3060; TSSOP-28_4.4x9.7mm_P0.65mm; MPN PCM3060PWR; LCSC C2651841
U6: TPS62170DSGR; Texas_DSG0008A_WSON-8-1EP_2x2mm_P0.5mm_EP0.9x1.6mm; MPN TPS62170DSGR; LCSC C124041
U7: LD1117S50; SOT-223-3_TabPin2; MPN LD1117S50CTR; LCSC C81157
U8: USBLC6-2SC6; SOT-23-6; MPN USBLC6-2SC6; LCSC C7519
U12: TL074; SOIC-14_3.9x8.7mm_P1.27mm; MPN TL074IDT; LCSC C107644
U13, U14, U15: MCP6004; SOIC-14_3.9x8.7mm_P1.27mm; MPN MCP6004T-I/SL; LCSC C7378
U16: LM4040DBZ-10; SOT-23; MPN LM4040C10IDBZR; LCSC C201738
Y1: 16MHz; Crystal_SMD_3215-2Pin_3.2x1.5mm; MPN X322516MLB4SI; LCSC C13738

Connections:
+3V3: C1.1, C2.1, C3.1, C4.1, C5.1, C6.1, C7.1, C8.1, C9.1, C10.1, C11.1, C12.1, C18.1, C19.1, C20.1, C21.1, C22.1, C23.1, C24.1, C25.1, C26.1, C27.1, C28.1, C29.1, C30.1, C32.1, C36.1, C46.1, C51.1, C52.1, C204.1, C205.1, C206.1, C207.1, FB5.1, J4.1, J5.A10 (+3V3), L1.2, R1.1, R2.1, R3.1, R12.1, R15.1, R21.2, R160.1, R168.1, R169.1, SW2.2, U1.C1 (VBAT), U1.C5 (VDD), U1.C6 (PDR_ON), U1.C7 (VDD), U1.C8 (VDD), U1.C9 (VDD), U1.F3 (VDD), U1.G3 (VDD), U1.G13 (VDD), U1.H13 (VDD33_USB), U1.J12 (VDD), U1.J13 (VDD), U1.K4 (VDD), U1.N8 (VDD), U1.N9 (VDD), U1.N10 (VDD), U2.8 (VCC), U3.A7 (VDD), U3.B2 (VDDQ), U3.B7 (VDDQ), U3.C9 (VDDQ), U3.D9 (VDDQ), U3.E1 (VDDQ), U3.F9 (VDD), U3.L1 (VDDQ), U3.L7 (VDD), U3.M9 (VDDQ), U3.N9 (VDDQ), U3.P2 (VDDQ), U3.P7 (VDDQ), U3.R7 (VDD), U4.7 (V_{DD}), U4.15 (~RST), U6.6 (VOS)
+3V3A: C15.1, C16.1, C17.1, C31.1, C34.1, C53.1, C54.1, C62.1, FB1.2, FB5.2, U1.P1 (VREF+), U1.R1 (VDDA)
+5V: C60.1, C61.1, C141.1, C142.1, C143.1, FB8.2, FB9.1, J5.A6 (+5V), U13.4 (V+), U14.4 (V+), U15.4 (V+)
+5VA: C202.1, C203.1, FB9.2, U4.24 (V_{CC})
+12V: C56.1, C57.1, C112.1, D1.1 (K), D5.1 (K), FB3.1, FB7.1, U12.4 (V+)
-12V: C58.1, C59.1, C113.1, D2.2 (A), R170.2, U12.11 (V-)
ADCJACK_9: J5.A2 (UART_RX), R148.1
ADCJACK_10: J5.A3 (UART_TX), R149.1
ADCJACK_11: J5.D9 (SPI_MOSI), R150.1
ADCJACK_12: J5.D8 (SPI_MISO), R151.1
ADC_9: C134.1, R148.2, U1.N2 (PA1)
ADC_10: C135.1, R149.2, U1.N3 (PA0)
ADC_11: C136.1, R150.2, U1.M5 (PC3_C)
ADC_12: C137.1, R151.2, U1.M4 (PC2_C)
AUDIO_OUT_L: J5.B2 (AUDIO_OUT_L), R116.2
AUDIO_OUT_R: J5.B1 (AUDIO_OUT_R), R123.2
A_IN: C47.1, C48.1, R11.2
A_OUT: C50.1, FB1.1
BOOT0: C201.1, R4.1, R201.2, SW2.1, U1.D6 (BOOT0)
BOOT_FLASH: R201.1, U1.K15 (PG3)
CODEC_IN_L: R105.2, U4.25 (V_{IN}L)
CODEC_IN_R: R102.2, U4.26 (V_{IN}R)
CODEC_OUT_L+: R110.1, U4.20 (V_{OUT}L+)
CODEC_OUT_L-: R113.1, U4.19 (V_{OUT}L-)
CODEC_OUT_R+: R117.1, U4.18 (V_{OUT}R+)
CODEC_OUT_R-: R120.1, U4.17 (V_{OUT}R-)
CODEC_VCOM: C55.1, C102.1, C105.1, U4.21 (V_{COM}), U12.10 (+), U12.12 (+)
CVJACK_1: J5.C5 (CV1), R124.1
CVJACK_2: J5.C4 (CV2), R125.1
CVJACK_3: J5.C3 (CV3), R126.1
CVJACK_4: J5.C2 (CV4), R127.1
CVJACK_5: J5.C6 (CV5), R128.1
CVJACK_6: J5.C7 (CV6), R129.1
CVJACK_7: J5.C8 (CV7), R130.1
CVJACK_8: J5.C9 (CV8), R131.1
CVOUT_1: J5.C10 (CV_OUT_1), R158.2
CVOUT_1_O: R156.2, R158.1, U15.1
CVOUT_2: J5.C1 (CV_OUT_2), R159.2
CVOUT_2_O: R157.2, R159.1, U15.7
CVO_FB_1: R154.1, R156.1, U15.2 (-)
CVO_FB_2: R155.1, R157.1, U15.6 (-)
CVO_FILT_1: C138.1, R152.2, U15.3 (+)
CVO_FILT_2: C139.1, R153.2, U15.5 (+)
CV_1: C126.1, R140.1, U1.R2 (PA3), U13.1
CV_2: C127.1, R141.1, U1.P3 (PA6), U13.7
CV_3: C128.1, R142.1, U1.P2 (PA2), U13.8
CV_4: C129.1, R143.1, U1.R3 (PA7), U13.14
CV_5: C130.1, R144.1, U1.R4 (PB1), U14.1
CV_6: C131.1, R145.1, U1.N5 (PC4), U14.7
CV_7: C132.1, R146.1, U1.M2 (PC0), U14.8
CV_8: C133.1, R147.1, U1.M3 (PC1), U14.14
CV_OUT_1: R152.1, U1.N4 (PA4)
CV_OUT_2: R153.1, U1.P4 (PA5)
FB_BK: R12.2, R13.1, U6.5 (FB)
FMC_A0: U1.E2 (PF0), U3.G8 (A0)
FMC_A1: U1.H3 (PF1), U3.G9 (A1)
FMC_A2: U1.H2 (PF2), U3.F7 (A2)
FMC_A3: U1.J2 (PF3), U3.F3 (A3)
FMC_A4: U1.J3 (PF4), U3.G1 (A4)
FMC_A5: U1.K3 (PF5), U3.G2 (A5)
FMC_A6: U1.P6 (PF12), U3.G3 (A6)
FMC_A7: U1.N6 (PF13), U3.H1 (A7)
FMC_A8: U1.R7 (PF14), U3.H2 (A8)
FMC_A9: U1.P7 (PF15), U3.J3 (A9)
FMC_A10: U1.N7 (PG0), U3.G7 (A10)
FMC_A11: U1.M7 (PG1), U3.H9 (A11)
FMC_A12: U1.L15 (PG2), U3.H3 (A12)
FMC_BA0: U1.K14 (PG4), U3.J7 (BA0)
FMC_BA1: U1.K13 (PG5), U3.H8 (BA1)
FMC_D0: U1.M14 (PD14), U3.R8 (DQ0)
FMC_D1: U1.L14 (PD15), U3.N7 (DQ1)
FMC_D2: U1.B12 (PD0), U3.R9 (DQ2)
FMC_D3: U1.C12 (PD1), U3.N8 (DQ3)
FMC_D4: U1.R8 (PE7), U3.P9 (DQ4)
FMC_D5: U1.P8 (PE8), U3.M8 (DQ5)
FMC_D6: U1.P9 (PE9), U3.M7 (DQ6)
FMC_D7: U1.R9 (PE10), U3.L8 (DQ7)
FMC_D8: U1.P10 (PE11), U3.L2 (DQ8)
FMC_D9: U1.R10 (PE12), U3.M3 (DQ9)
FMC_D10: U1.N11 (PE13), U3.M2 (DQ10)
FMC_D11: U1.P11 (PE14), U3.P1 (DQ11)
FMC_D12: U1.R11 (PE15), U3.N2 (DQ12)
FMC_D13: U1.P15 (PD8), U3.R1 (DQ13)
FMC_D14: U1.P14 (PD9), U3.N3 (DQ14)
FMC_D15: U1.N15 (PD10), U3.R2 (DQ15)
FMC_D16: U1.M12 (PH8), U3.E8 (DQ16)
FMC_D17: U1.M13 (PH9), U3.D7 (DQ17)
FMC_D18: U1.L13 (PH10), U3.D8 (DQ18)
FMC_D19: U1.L12 (PH11), U3.B9 (DQ19)
FMC_D20: U1.K12 (PH12), U3.C8 (DQ20)
FMC_D21: U1.E12 (PH13), U3.A9 (DQ21)
FMC_D22: U1.E13 (PH14), U3.C7 (DQ22)
FMC_D23: U1.D13 (PH15), U3.A8 (DQ23)
FMC_D24: U1.E14 (PI0), U3.A2 (DQ24)
FMC_D25: U1.D14 (PI1), U3.C3 (DQ25)
FMC_D26: U1.C14 (PI2), U3.A1 (DQ26)
FMC_D27: U1.C13 (PI3), U3.C2 (DQ27)
FMC_D28: U1.C3 (PI6), U3.B1 (DQ28)
FMC_D29: U1.C2 (PI7), U3.D2 (DQ29)
FMC_D30: U1.D3 (PI9), U3.D3 (DQ30)
FMC_D31: U1.E3 (PI10), U3.E2 (DQ31)
FMC_NBL0: U1.A4 (PE0), U3.K9 (DQM0)
FMC_NBL1: U1.A3 (PE1), U3.K1 (DQM1)
FMC_NBL2: U1.D4 (PI4), U3.F8 (DQM2)
FMC_NBL3: U1.C4 (PI5), U3.F2 (DQM3)
FMC_SDCKE0: U1.F4 (PH2), U3.J2 (CKE)
FMC_SDCLK: U1.H14 (PG8), U3.J1 (CLK)
FMC_SDNCAS: U1.B7 (PG15), U3.K7 (CAS#)
FMC_SDNE0: U1.G4 (PH3), U3.J8 (CS#)
FMC_SDNRAS: U1.R6 (PF11), U3.J9 (RAS#)
FMC_SDNWE: U1.J4 (PH5), U3.K8 (WE#)
GATEJACK_1: J5.B10 (GATE_IN_1), R164.1
GATEJACK_2: J5.B9 (GATE_IN_2), R165.1
GATEOUT_1: J5.B5 (GATE_OUT_1), R162.2
GATEOUT_1_O: R162.1, U15.8
GATEOUT_2: J5.B6 (GATE_OUT_2), R163.2
GATEOUT_2_O: R163.1, U15.14
GATE_IN_1: Q1.3 (C), R168.2, R202.1
GATE_IN_1_MCU: R202.2, U1.A8 (PG13)
GATE_IN_2: Q2.3 (C), R169.2, R203.1
GATE_IN_2_MCU: R203.2, U1.A7 (PG14)
GATE_OUT_1: U1.E1 (PC14), U15.10 (+)
GATE_OUT_2: U1.D1 (PC13), U15.12 (+)
GBASE_1: Q1.1 (B), R164.2, R166.1
GBASE_2: Q2.1 (B), R165.2, R167.1
GND: C1.2, C2.2, C3.2, C4.2, C5.2, C6.2, C7.2, C8.2, C9.2, C10.2, C11.2, C12.2, C13.2, C14.2, C15.2, C16.2, C17.2, C18.2, C19.2, C20.2, C21.2, C22.2, C23.2, C24.2, C25.2, C26.2, C27.2, C28.2, C29.2, C30.2, C31.2, C32.2, C34.2, C35.2, C36.2, C37.2, C38.2, C39.2, C44.2, C45.2, C46.2, C47.2, C48.2, C50.2, C51.2, C52.2, C53.2, C54.2, C55.2, C56.2, C57.2, C58.2, C59.2, C60.2, C61.2, C62.2, C63.2, C102.2, C105.2, C112.2, C113.2, C122.2, C125.2, C134.2, C135.2, C136.2, C137.2, C138.2, C139.2, C140.2, C141.2, C142.2, C143.2, C201.2, C202.2, C203.2, C204.2, C205.2, C206.2, C207.2, D3.1 (K), D4.1 (K), J3.5 (GND), J3.SH (Shield), J4.3, J4.5, J4.9, J5.A4 (GND), J5.A7 (GND), Q1.2 (E), Q2.2 (E), R4.2, R13.2, R115.2, R122.2, R154.2, R155.2, R161.2, R166.2, R167.2, SW1.2, U1.D5 (VSS), U1.D7 (VSS), U1.D8 (VSS), U1.D9 (VSS), U1.F2 (VSS), U1.F6 (VSS), U1.F7 (VSS), U1.F8 (VSS), U1.F9 (VSS), U1.F10 (VSS), U1.F12 (VSS), U1.G2 (VSS), U1.G6 (VSS), U1.G7 (VSS), U1.G8 (VSS), U1.G9 (VSS), U1.G10 (VSS), U1.G12 (VSS), U1.H6 (VSS), U1.H7 (VSS), U1.H8 (VSS), U1.H9 (VSS), U1.H10 (VSS), U1.H12 (VSS), U1.J6 (VSS), U1.J7 (VSS), U1.J8 (VSS), U1.J9 (VSS), U1.J10 (VSS), U1.K6 (VSS), U1.K7 (VSS), U1.K8 (VSS), U1.K9 (VSS), U1.K10 (VSS), U1.L4 (VSS), U1.M1 (VSSA), U1.M8 (VSS), U1.M9 (VSS), U1.N1 (VREF-), U2.4 (GND), U3.A3 (VSS), U3.B3 (VSSQ), U3.B8 (VSSQ), U3.C1 (VSSQ), U3.D1 (VSSQ), U3.E9 (VSSQ), U3.F1 (VSS), U3.L3 (VSS), U3.L9 (VSSQ), U3.M1 (VSSQ), U3.N1 (VSSQ), U3.P3 (VSSQ), U3.P8 (VSSQ), U3.R3 (VSS), U4.8 (DGND), U4.16 (SGND), U4.22 (AGND2), U4.23 (AGND1), U4.27 (~MS/AD/IFMD), U4.28 (MODE), U6.1 (PGND), U6.4 (AGND), U6.9 (PAD), U7.1 (GND), U8.2 (GND), U13.3 (+), U13.5 (+), U13.10 (+), U13.11 (V-), U13.12 (+), U14.3 (+), U14.5 (+), U14.10 (+), U14.11 (V-), U14.12 (+), U15.11 (V-), U16.1 (K)
I2C1_SCL: J5.B7 (I2C1_SCL), U1.A5 (PB8)
I2C1_SDA: J5.B8 (I2C1_SDA), U1.B4 (PB9)
I2C2_SCL: R2.2, U1.R12 (PB10), U4.1 (MC/SCL/FMT)
I2C2_SDA: R1.2, U1.R13 (PB11), U4.2 (MD/SDA/DEMP)
INPUT_+12V: D1.2 (A), J5.A5 (+12V)
INPUT_-12V: D2.1 (K), J5.A1 (-12V)
INPUT_AUDIO_LEFT: C103.1, J5.B4 (AUDIO_IN_L)
INPUT_AUDIO_RIGHT: C100.1, J5.B3 (AUDIO_IN_R)
JTDI: J4.8, U1.A13 (PA15)
LD_IN: C63.1, FB7.2, U7.3 (VI)
LD_OUT: FB8.1, U7.2 (VO)
LED_A: D3.2 (A), R14.2
LED_USER: R14.1, U1.G15 (PC7)
LINL_M: C104.1, R103.2, R104.1, U12.13 (-)
LINL_O: C104.2, R104.2, R105.1, U12.14
NC_U3_E3: U3.E3 (NC)
NC_U3_E7: U3.E7 (NC)
NC_U3_H7: U3.H7 (NC)
NC_U3_K2: U3.K2 (NC)
NC_U3_K3: U3.K3 (NC)
NRST: C39.1, J4.10, R3.2, SW1.1, U1.J1 (NRST)
N_LINA: C103.2, R103.1
N_OLA: C121.1, R110.2, R111.1, R112.2
N_OLB: C121.2, R113.2, R114.1, R115.1
N_ORA: C124.1, R117.2, R118.1, R119.2
N_ORB: C124.2, R120.2, R121.1, R122.1
N_RINA: C100.2, R100.1
OL_INV: C120.2, R111.2, U12.6 (-)
OL_NINV: C122.1, R114.2, U12.5 (+)
OL_OUT: C120.1, R112.1, R116.1, U12.7
OR_INV: C123.2, R118.2, U12.2 (-)
OR_NINV: C125.1, R121.2, U12.3 (+)
OR_OUT: C123.1, R119.1, R123.1, U12.1
OSC_IN: C37.1, U1.G1 (PH0), Y1.1
OSC_OUT: C38.1, U1.H1, Y1.2
PWR_A: D4.2 (A), R15.2
QSPI_CLK: U1.L1 (PF10), U2.6 (CLK)
QSPI_IO0: U1.L3 (PF8), U2.5 (IO0)
QSPI_IO1: U1.L2 (PF9), U2.2 (IO1)
QSPI_IO2: U1.K1 (PF7), U2.3 (IO2)
QSPI_IO3: U1.K2 (PF6), U2.7 (IO3)
QSPI_NCS: R21.1, U1.J15 (PG6), U2.1 (CS#)
RINR_M: C101.1, R100.2, R101.1, U12.9 (-)
RINR_O: C101.2, R101.2, R102.1, U12.8
SAI1_FS: U1.B1 (PE4), U4.4 (LRCK1), U4.11 (LRCK2)
SAI1_MCLK: U1.A2 (PE2), U4.6 (SCKI1), U4.9 (SCKI2)
SAI1_SCK: U1.B2 (PE5), U4.5 (BCK1), U4.10 (BCK2)
SAI1_SDA: U1.B3 (PE6), U4.3 (DOUT)
SAI1_SDB: U1.A1 (PE3), U4.12 (DIN)
SDMMC1_CK: J5.D6 (SDMMC_CK), U1.A12 (PC12)
SDMMC1_CMD: J5.D7 (SDMMC_CMD), U1.D12 (PD2)
SDMMC1_D0: J5.D5 (SDMMC_D0), U1.G14 (PC8)
SDMMC1_D1: J5.D4 (SDMMC_D1), U1.F14 (PC9)
SDMMC1_D2: J5.D3 (SDMMC_D2), U1.B14 (PC10)
SDMMC1_D3: J5.D2 (SDMMC_D3), U1.B13 (PC11)
SPI2_CS: J5.D1 (SPI_NSS), U1.A9 (PB4)
SPI2_SCK: J5.D10 (SPI_SCK), U1.D11 (PD3)
SUM_1: C126.2, R124.2, R132.2, R140.2, U13.2 (-)
SUM_2: C127.2, R125.2, R133.2, R141.2, U13.6 (-)
SUM_3: C128.2, R126.2, R134.2, R142.2, U13.9 (-)
SUM_4: C129.2, R127.2, R135.2, R143.2, U13.13 (-)
SUM_5: C130.2, R128.2, R136.2, R144.2, U14.2 (-)
SUM_6: C131.2, R129.2, R137.2, R145.2, U14.6 (-)
SUM_7: C132.2, R130.2, R138.2, R146.2, U14.9 (-)
SUM_8: C133.2, R131.2, R139.2, R147.2, U14.13 (-)
SWCLK: J4.4, U1.A14
SWDIO: J4.2, U1.A15 (PA13)
SWO: J4.6, U1.A10 (PB3)
SW_BK: L1.1, U6.7 (SW)
UNREG: C35.1, C44.1, FB2.1, R11.1
USB_DM: J5.A8 (USB_DM), U1.R14 (PB14)
USB_DP: J5.A9 (USB_DP), U1.R15 (PB15)
USB_FS_DM: J3.2 (D-), U1.C15 (PA11), U8.1 (I/O1), U8.6 (I/O1)
USB_FS_DP: J3.3 (D+), U1.B15 (PA12), U8.3 (I/O2), U8.4 (I/O2)
VBUS: D5.2 (A), J3.1 (VBUS), U8.5 (VBUS)
VCAP: C13.1, C14.1, U1.F13 (VCAP), U1.M10 (VCAP)
VIN_BK: C45.1, FB2.2, FB3.2, U6.2 (VIN), U6.3 (EN)
VREF_N10: C140.1, R132.1, R133.1, R134.1, R135.1, R136.1, R137.1, R138.1, R139.1, R170.1, U16.2 (A)
VTH: R160.2, R161.1, U15.9 (-), U15.13 (-)

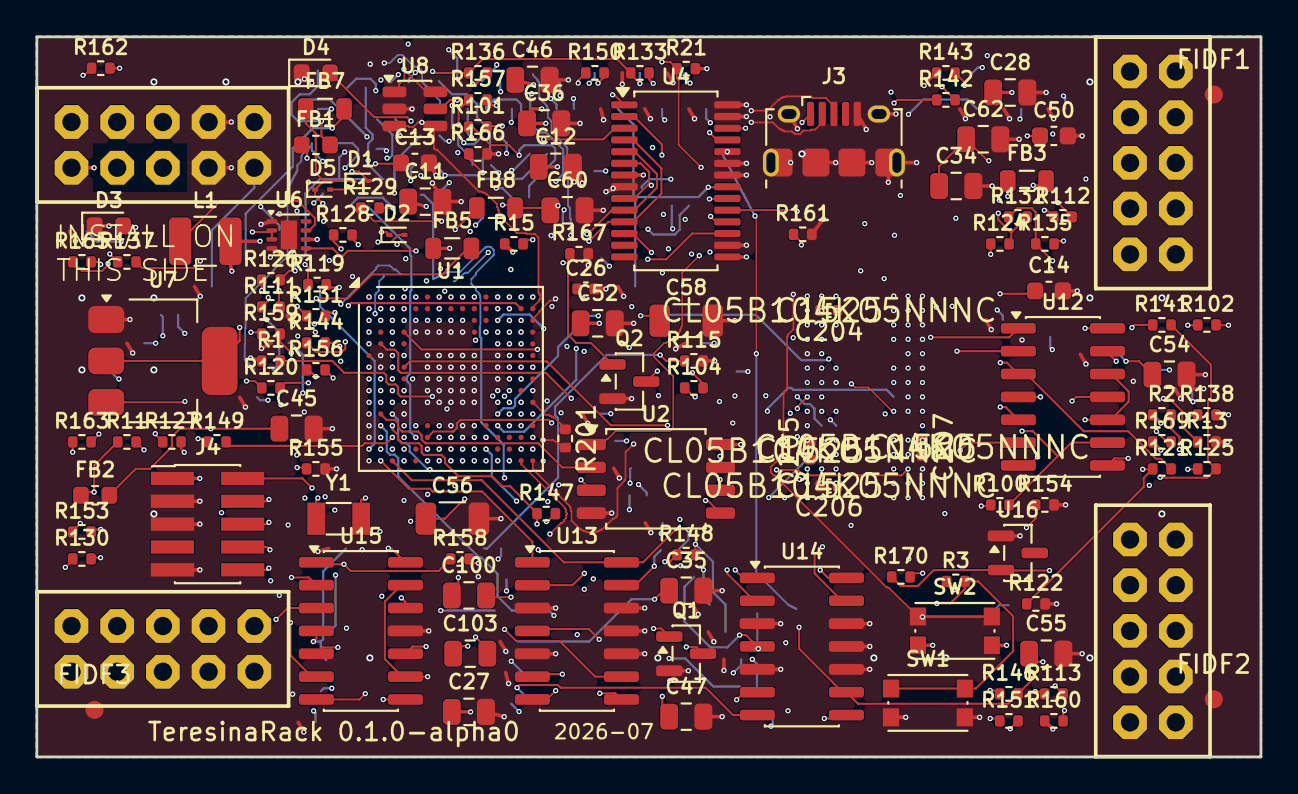
[picture p4: board TeresinaRack.kicad_pcb from above]

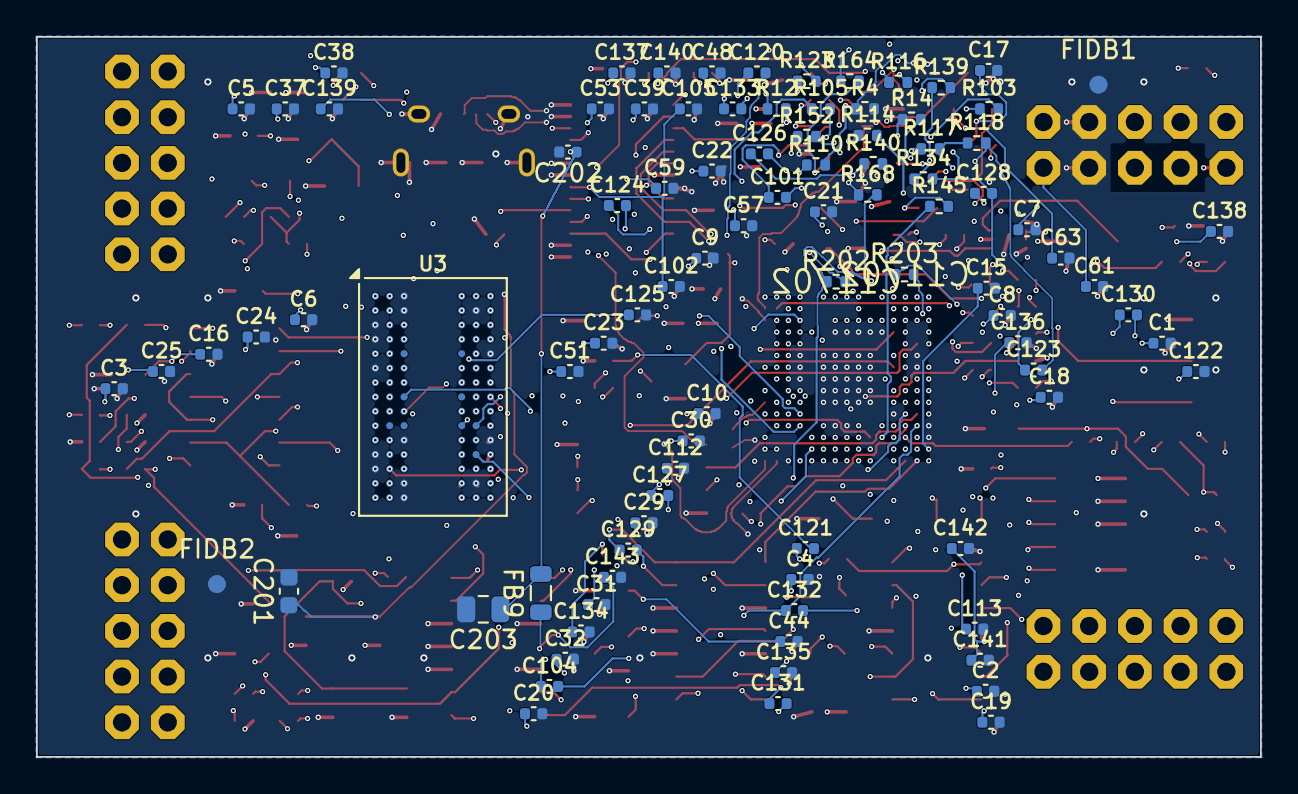
[picture p5: board TeresinaRack.kicad_pcb from below]

Board: 12 copper layers, 68.0 x 40.0 mm, 214 parts (93 on the bottom side), 200 nets.

Other parts of the board:
FIDB1, FIDB2: Fiducial_1mm_Mask2mm
FIDF1, FIDF2, FIDF3: Fiducial_1mm_Mask2mm
