marcoallegretti/Teresina-Rack/(commit log)

2026-07-17 Initial commit: schematic + PCB foundation
    Daisy Patch SM-compatible Eurorack submodule (STM32H750, 68x40mm).
    Netlist-verified schematic: STM32/SDRAM/QSPI core, PCM3060 codec, +/-12V
    power tree, TL074 audio front-end, CV/gate block, 40-pad edge connector.
    8-layer HDI PCB with all 198 footprints synced, 68x40 outline, and anchor
    placement of the major ICs.
    [TeresinaRack.kicad_pcb, TeresinaRack.kicad_sch]
2026-07-17 PCB: placement, power/ground planes, BGA via-in-pad fanout
    Full double-sided placement on the 68x40 outline (digital core, analog
    partition, connector-driven). In1=GND / In6=+3V3 planes plus F/B ground
    fills. SDRAM offset from the STM32 so both BGAs use through-via-in-pad;
    253 vias bond all power/ground balls to the planes and give signal balls
    inner-layer escapes. Signal routing pending.
    [TeresinaRack.kicad_pcb]
2026-07-17 PCB: route all signal nets (Freerouting)
    All signal nets routed on the 8-layer board (FMC, QSPI, SAI, USB, SDMMC,
    I2C, audio, CV/gate) with 0 clearance violations; 3675 segments, 664 vias.
    Power/ground decoupling-to-plane connections (~106) still to complete.
    [TeresinaRack.dsn, TeresinaRack.kicad_pcb]
2026-07-17 Remove autorouter intermediates (.dsn/.ses) from repo
    [TeresinaRack.dsn]
2026-07-18 PCB: complete routing, DRC-clean
    Stitched every power pad to the GND/+3V3 planes (168 fan-out vias) and routed
    all remaining signals (Freerouting 2.x + a custom A* finisher for the last net).
    Cleared all clearance, board-edge, thermal-relief and courtyard errors:
    0 DRC errors, 0 shorts, all 238 nets connected.
    [TeresinaRack.kicad_pcb]
2026-07-18 PCB: remove dangling router stubs, tidy silkscreen
    Strip the 21 single-ended router stubs left by the autorouter, hide component
    values, and set reference designators to the 0.8mm silk minimum. Still 0 DRC
    errors, all nets connected.
    [TeresinaRack.kicad_pcb]
2026-07-18 PCB: 10-layer re-route with solid GND/+3V3 planes; validation fixes
    - 10 layers: In1 solid GND, In6 solid +3V3 (zero traces on either), 8 signal layers
    - FMC_A4 routed on In7; GND stitching + USB return vias; fiducials 3xF 1xB
    - Schematic: LCSC/MPN part numbers on all parts; removed 13 orphan labels/wires
    (netlist verified identical); ERC/DRC clean; analog paths SPICE-verified
    [TeresinaRack.kicad_pcb, TeresinaRack.kicad_sch]
2026-07-18 Patch SM compatibility fixes from deep audit vs official sources
    - USB: micro-USB moved to PA11/PA12 (OTG_FS, ROM DFU) with USBLC6; edge pads
    A8/A9 direct to PB14/15 (OTG_HS) per official Rev3 schematic
    - PG3 boot strap added (R201 4K7 + C201 2.2uF into BOOT0) for software DFU
    - CV-out gain resistors to official 120K/62K (51.5k unavailable at JLC)
    - QSPI_NCS flash leg re-routed via In8; routing artifacts cleaned
    - BOM 100% LCSC-resolved; silk name/rev; USB/boot 0.09mm rule (.kicad_dru)
    - DRC 0 errors, 0 unconnected; planes solid; SPICE 59/59
    [TeresinaRack.kicad_pcb, TeresinaRack.kicad_sch]
2026-07-18 Add README with design, validation and fabrication docs; board renders
    Also hide LCSC/MPN footprint field text that leaked onto silkscreen
    (gerbers regenerated)
    [TeresinaRack.kicad_pcb]
2026-07-18 Correct version to 0.1.0-alpha0 (silk, renders, README status note)
    [TeresinaRack.kicad_pcb]
2026-07-20 Fix critical SDRAM symbol bug; reroute on 12 layers
    The custom AS4C16M32MSA symbol (shared with the Teresina board) had 5
    control/address balls scrambled vs the Alliance Memory datasheet: CLK, CKE,
    BA0, A2, A9 were assigned to the wrong balls (a single 5-cycle in the J row),
    which would leave the 64 MB SDRAM dead on every board. This was invisible to
    the earlier audit because every check compared the board against this (wrong)
    symbol. Corrected the ball numbers in TeresinaRack.kicad_sym and the cached
    copy in .kicad_sch; the flash IS25LP064A symbol was audited and is correct.
    The 5 corrected nets could not be rerouted on the 10-layer board (the STM32's
    0.65 mm-pitch BGA escape cannot fit 5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
    [TeresinaRack.kicad_pcb, TeresinaRack.kicad_sch]
2026-07-20 Match official Rev3: audio MFB cap placement + gate-in collector pull-up
    Evidence-based re-audit against the official Patch SM Rev3 confirmed the board
    is a faithful copy (symbols all match datasheets, analog blocks part-for-part).
    Corrected two deviations toward the official design:
    - Audio output MFB filter: moved the 18 pF feedback cap (C120/C123) from across
    the 39K T-branch to the op-amp inverting input -- the canonical MFB placement,
    restoring codec-to-single-ended CMRR and phase margin. Schematic relabelled and
    the two nets rerouted on the audio layers; 0 unconnected, DRC unchanged.
    - Gate-in collector pull-up 100K -> 10K (R168/R169, LCSC C72443) to match official
    and stay ro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
    [TeresinaRack.kicad_pcb, TeresinaRack.kicad_sch]
2026-07-20 Gate-in base pull-down 100K->1M (R166/R167, LCSC C26083)
    Completes the gate-in value match to the official Rev3: base pull-down set to
    the official 1M (verified UNI-ROYAL 0402WGF1004TCE = LCSC C26083, in stock at
    JLCPCB). Schematic value+LCSC and PCB value updated. Metadata-only (no copper
    change); DRC/ERC unchanged.
    [TeresinaRack.kicad_pcb, TeresinaRack.kicad_sch]
2026-07-21 Add gate-in 1K series resistors; fix latent audio bridge-cap and sourcing bugs
    - Gate-in 1K collector series R (R202/R203) into PG13/PG14, matching official Rev3
    - Fix C121/C124 MFB bridge caps mis-wired to *_INV in schematic (should be N_OxA junctions)
    - Correct stale LCSC/MPN on R166-169 (100K->1M/10K parts) and set R202/R203 (1K)
    - README: 201 parts/51 groups/825 vias; deviations rewritten
    [TeresinaRack.kicad_pcb, TeresinaRack.kicad_sch]
2026-07-21 Fix critical PCM3060 analog supply (audio) + LM4040 reference sourcing
    Forensic audio audit vs official Rev3 + full kicad-happy suite.
    - Codec V_CC (U4.24) was on +3V3A (3.3V); PCM3060 datasheet requires 4.5-5.5V
    analog. Added ferrite-filtered +5VA rail (FB9 + C202 100nF + C203 10uF) to
    pin 24 -> correct VCOM (2.5V) and full-scale audio. PWR_FLAG on +5VA.
    - U16 LM4040: value was 10V but MPN/LCSC pointed to a 3.0V part
    (LM4040B30/C460604); corrected to LM4040C10IDBZR / C201738 (10V).
    - DRC 0 shorts / 0 unconnected; ERC 3 pre-existing benign; SPICE 63/63.
    - README: codec-supply fix, +5VA rail, 204 parts / 829 vias.
    [TeresinaRack.kicad_pcb, TeresinaRack.kicad_sch]
2026-07-21 Fix via-in-keepout and add bottom-side fiducials
    - Move +3V3 edge-feed via (3.18,7.27) out of the F/B keepout zone
    - Add FIDB2/FIDB3 (B.Cu) for double-sided assembly vision (3 bottom fiducials)
    - U6 PG left unconnected by design (unused open-drain, no pull-up needed)
    [TeresinaRack.kicad_pcb]
2026-07-21 Resolve codec-supply/J3 collision: relocate +5VA parts, route via analog corridor
    - FB9/C202/C203 were inside the J3 micro-USB body (FB9 2.1mm2, C202 0.41mm2 overlap)
    - Relocate to B.Cu: C202 (100nF) in the clear pocket under U4.24; FB9+C203 by the
    analog +5V rail. Route +5VA up the analog corridor (from U14 area) to a via-in-pad
    at U4.24 - avoids the saturated inter-BGA band. 0mm2 J3-body overlap now.
    - Revert the +3V3 edge via to its original spot (KiCad DRC has no keepout error there;
    the earlier move created a real hole-to-hole vs J5.A10). Drop FIDB3 (no clear spot).
    - DRC: 0 shorts / 0 clearance / 0 hole / 0 unconnected. Only pre-existing R201 courtyard.
    [TeresinaRack.kicad_pcb]
2026-07-21 Fix SDRAM A2/A9 ball swap; switch SDRAM to ISSI IS42S32160F
    - A2/A9 address lines were swapped at U3 (ball J3 must=A9, F7 must=A2
    per datasheet); corrected symbol pin numbers + rerouted FMC_A2/FMC_A9.
    - SDRAM -> ISSI IS42S32160F-6BLI (LCSC C1348852): native 3.3V, JLC-stocked,
    ball-map identical to AS4C16M32, libDaisy-compatible. Alliance MSA was a
    1.8V mobile part run out-of-spec and not orderable at JLC.
    - README/BOM sourcing notes corrected.
    [TeresinaRack.kicad_pcb, TeresinaRack.kicad_sch]
2026-07-21 Fab-readiness pass: SDRAM decoupling, debris cleanup, doc fixes
    - Add C204-C207 (100nF 0402, F.Cu under U3): SDRAM +3V3 ball decoupling
    coverage 4/14 -> 14/14 within 5mm. Verified congruent (sch+pcb+BOM),
    0 existing footprints moved, DRC 0-err/0-unconnected.
    - Remove 84 autorouter-debris track stubs + 2 orphan vias (track_dangling
    9 -> 0); connectivity provably intact.
    - README: J5 is through-hole pin-header (NOT castellated - do not enable
    castellated holes at order); U1 top / U3 bottom; honest DRC/ERC counts;
    document accepted VCAP-12mm and R201 courtyard margins with evidence;
    part count 208.
    - VCAP relocation and R201 nudge assessed and deliberately NOT forced
    (would rip up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
    [TeresinaRack.kicad_pcb, TeresinaRack.kicad_sch]
2026-07-22 Add missing LCSC/MPN on C202/C203/FB9 (codec +5VA filter)
    These 3 parts (added with the +5VA codec-supply fix) had LCSC/MPN on
    the PCB footprint but NOT on the schematic symbol, so the schematic-
    generated BOM omitted them - they would have been left unpopulated at
    assembly. Set on the symbol to match the footprint:
    C202 100nF -> C1525, C203 10uF -> C15850, FB9 600R ferrite -> C175716.
    Full BOM re-audit: all 208 assembly parts now carry a valid LCSC.
    [TeresinaRack.kicad_sch]
2026-07-22 README: document 12-layer cost + layer-reduction roadmap (12->8->6)
    12-layer fab is expensive (hundreds of EUR/few boards, finest via tier).
    Layer count grew for routing tractability, not design necessity. Cutting
    layers (12->8->6) is the top cost-reduction goal, tracked as future work
    requiring hand-routed BGA escapes; automated reduction not tractable.
2026-10-17 chore(review): add machine-readable evidence
    Add the JSON and CSV outputs referenced by the production, firmware, analog, core, power, sourcing, and four-layer review documents. Keep generated evidence separate from the human-readable engineering record.
    [ballmap-audit.csv, component-review.csv, live-sourcing.csv]
